antoniancu/vw-t2-ms3-custom-wiring/Wires.xls

 | Item | Type | Rel. Connector | Rel Color | AVG |  | Front Connector | Rear Connector | Other Destination | Cable Color | Comment | Length | Amps | Source | FromTo
17 | Aux+ | Power | AuxPowerBar | Yellow | 16 | 1 | FuseBlock B+ |  |  |  |  | 9 |  |  | Center-Front
18 | Bat+ | Power | BatPowerBar | Red | 16 | 2 | FuseBlock A+ |  |  |  |  | 9 |  |  | Center-Front
3 | Day Run Bulbs | Power |  |  |  |  |  |  |  |  |  |  | 0.6 | Aux+ | Manual Length
29 | ColdAirHSpeed | Power | C12M P3 | Yellow/Green | 16 | 3 | Conn2Fan2 P2 |  |  |  | 3.5 x 2 | 9 | 7 | Aux+ | Center-Front
2 | Off Road Lights | Power | C9L P2 | Yellow/Black | 18 | 1 | Conn1OffRoadLight P1 |  |  |  |  | 9 |  |  | Center-Front
4 | Low Beam Bulb Right | Power | C9L P4 | Green/Black | 18 | 2 | Conn3BeamR |  |  |  |  | 9 | 1.4 | Aux+ | Center-Front
5 | Low Beam Bulb Left | Power | C9L P5 | Green/Black/White | 18 | 3 | Conn3BeamL |  |  |  |  | 9 | 1.4 | Aux+ | Center-Front
7 | High Beam Bulb Right | Power | C9L P7 | Blue/Black | 18 | 4 | Conn3BeamR |  |  |  |  | 9 | 2.1 | Aux+ | Center-Front
8 | High Beam Bulb Left | Power | C9L P8 | Blue/Black/White | 18 | 5 | Conn3BeamL |  |  |  |  | 9 | 2.1 | Aux+ | Center-Front
10 | Trunk | Cmd+ | C9/7 P1 | Green | 22 |  |  | ??? |  |  |  | 16 |  |  | Center-Rear
11 | CutOff | CmdGnd | C9/7 P2 | Yellow | 22 |  |  | ??? |  |  |  | 16 |  |  | Center-Rear
15 | DoorOpen1 | Power | C9/7 P7 | White | 18 | 6 | Conn2RDoorOpen P1 |  |  |  |  | 9 | 3 | Bat+ | Center-Front
13 | Alarm BrakeTemoin | In | C9/7 P4 | Orange | 22 |  |  |  | Brake Pump Pins 81 |  |  | 6 |  |  | Manual Length
16 | DoorOpen2 | Power | C9/7 P6 | White/Black | 18 | 7 | Conn2RDoorOpen P2 |  |  |  |  | 9 | 3 | Bat+ | Center-Front
21 | WaserPump | Power | C34 P3 | Blue | 18 | 8 | Conn2WasherPump P1 |  |  |  |  | 9 | 1 |  | Center-Front
27 | WiperMotor_53 | Power | C12M P1 | Blue | 18 | 9 | ConnWiper 53 |  |  |  |  | 9 |  |  | Center-Front
28 | WiperMotor_53b | Power | C12M P2 | Green | 18 | 10 | ConnWiper 53b |  |  |  |  | 9 |  |  | Center-Front
30 | ColdAirLSpeed | Power | C12M P4 | White/Green | 18 | 11 | Conn2Fan2 P1 |  |  |  | 1.15 x 2 | 9 | 2.3 | Aux+ | Center-Front
33 | TurnPower | Power | C12M P7 | Red/Yellow | 18 | 12 | Conn9HSW P9 |  |  |  |  | 9 |  |  | Center-Front
35 | TurnBulbRF | Power | C12M P9 | Green/Black | 18 | 13 | Conn3FPR P1 |  |  |  |  | 9 | 1.5 | Aux+Bat+ | Center-Front
36 | TurnBulbLR | Power | C12M P10 | Blue/Black | 18 | 14 | ??? |  |  |  |  | 9 | 1.5 | Aux+Bat+ | Center-Front
37 | TurnBulbLF | Power | C12M P11 | Blue/Black | 18 | 15 | Conn3FPL P1 |  |  |  |  | 9 | 1.5 | Aux+Bat+ | Center-Front
1 | Off Road Cmd | CmdGnd | C9L P1 | Yellow | 22 | 1 | Conn3OffRoadSW P2 |  |  |  |  | 9 |  |  | Center-Front
6 | Low Beam Light Cmd | CmdGnd | C9L P6 | Green | 22 | 2 | Conn6Lights P6 |  |  |  |  | 9 |  |  | Center-Front
9 | Light Switch Cmd | CmdGnd | C9L P9 | Bkue | 22 | 3 | Conn6Dir P6 |  |  |  |  | 9 |  |  | Center-Front
12 | DoorSwitch | InGnd | C9/7 P3 | Blue | 22 | 4 | Conn1DoorSw |  |  |  |  | 9 |  |  | Center-Front
14 | Siren | Power | C9/7 P5 | Pink | 22 | 5 | Conn1Siren |  |  |  |  | 9 |  |  | Center-Front
19 | AuxCmd | CmdGnd | C34 P1 | Green | 22 | 6 | Conn4Key PinX |  |  |  |  | 9 |  |  | Center-Front
20 | WasherCmd | Cmd+ | C34 P2 | Blue | 22 | 7 | Conn7Wiper SW1 |  |  |  |  | 9 |  |  | Center-Front
22 | WiperMotor_53a | Power | C6/5 P1 | Yellow/Red | 22 | 8 | ConnWiper 53a |  |  |  |  | 9 |  |  | Center-Front
23 | WiperWCmd | Cmd+ | C6/5 P2 | White | 22 | 9 | Conn7Wiper SW2 |  |  |  |  | 9 |  |  | Center-Front
24 | WiperLTCmd | Cmd+ | C6/5 P3 | Blue + Blue/Black | 22 | 10 | Conn6WiperT P5 |  |  |  |  | 9 |  |  | Center-Front
25 | WiperMotor_53e | Cmd+ / Gnd | C6/5 P4 | Yellow | 22 | 11 | ConnWiper 53e |  |  |  |  | 9 |  |  | Center-Front
34 | TurnBulbRR | Power | C12M P8 | Green/Black | 18 |  |  | ??? |  |  |  | 16 | 1.5 | Aux+Bat+ | Center-Rear
26 | WiperHCmd | Cmd+ | C6/5 P5 | Green/Black | 22 | 12 | Conn7Wiper 53b |  |  |  |  | 9 |  |  | Center-Front
31 | ColdAirLCmd | CmdGnd | C12M P5 | White | 22 | 13 | Conn3ColdAirSW P1 |  |  |  |  | 9 |  |  | Center-Front
32 | ColdAirHCmd | CmdGnd | C12M P6 | Yellow | 22 | 14 | Conn3ColdAirSW P2 |  |  |  |  | 9 |  |  | Center-Front
38 | TurnIndicator | Power | C12M P12 | Black/Red | 22 | 15 | Conn9HSW P1 |  |  |  |  | 9 |  |  | Center-Front
39 | RightCmd | CmdGnd | C33 P3 | Green | 22 | 16 | Conn6Dir P3 |  |  |  |  | 9 |  |  | Center-Front
40 | HazardCmd | CmdGnd | C33 P2 | Yellow | 22 | 17 | Conn9HSW P8 |  |  |  |  | 9 |  |  | Center-Front
41 | LeftCmd | CmdGnd | C33 P1 | Blue | 22 | 18 | Conn6Dir P1 |  |  |  |  | 9 |  |  | Center-Front
42 | EngineBat+ | Power | BatPowerBar | Red | 16 |  |  | ??? |  |  |  | 16 |  |  | Center-Rear
43 | LeftSeatLCmd | Cmd+ | C42 P1 |  | 22 | 19 | Conn4SHL P4 |  |  |  |  | 9 |  |  | Center-Front
44 | LeftSeatHCmd | Cmd+ | C42 P2 |  | 22 | 20 | Conn4SHL P3 |  |  |  |  | 9 |  |  | Center-Front
45 | RightSeatLCmd | Cmd+ | C42 P3 |  | 22 | 21 | Conn4SHR P4 |  |  |  |  | 9 |  |  | Center-Front
46 | RightSeatHCmd | Cmd+ | C42 P4 |  | 22 | 22 | Conn4SGR P3 |  |  |  |  | 9 |  |  | Center-Front
47 | OilPresure | In+ |  |  | 22 | 1 | Conn4OilP P4 | Oil Presure Traductor |  |  |  | 25 |  |  | Front-Rear
48 | RPM | In+ |  |  | 22 | 2 | Conn9Dash P3 | Megasquirt |  |  |  | 25 |  |  | Front-Rear
49 | FuelLevel | In+ |  |  | 22 | 3 | Conn9Dash P4 | FuelTank |  |  |  | 25 |  |  | Front-Rear
50 | LowOilPresure | InGnd |  |  | 22 | 4 | Conn9Dash P5 | Megasquirt |  |  |  | 25 |  |  | Front-Rear
51 | AltCharge | InGnd |  |  | 22 | 5 | Conn9Dash P7 | Megasquirt |  |  |  | 25 |  |  | Front-Rear
52 | CheckEngine | InGnd |  |  | 22 | 6 | Conn9Dash P8 | Megasquirt |  |  |  | 25 |  |  | Front-Rear
53 | Brake | Sign+ |  |  | 22 |  | Conn4Brk P4 |  | Brake Pump Pins 81a |  |  | 6 |  |  | Manual Length
54 | HornPower | Power |  |  | 18 |  | FuseBlock B4 |  | Horn |  |  | 6 |  |  | Manual Length
55 | PowerBrakeSw | Power |  |  | 18 |  | FuseBlock B2 |  | Brake Pump Pins 82a |  |  | 9 | 3 | Aux+ | Manual Length
56 | CruiseControlGreen | Sign |  |  | 22 | 7 | Conn6Cruise 5 | CruiseControlUnit |  | Green |  | 25 |  |  | Front-Rear
57 | CruiseControlBrown | Sign |  |  | 22 | 8 | Conn6Cruise 4 | CruiseControlUnit |  | Brown |  | 25 |  |  | Front-Rear
58 | CruiseControlYellow | Sign |  |  | 22 | 9 | Conn6Cruise 3 | CruiseControlUnit |  | Yellow |  | 25 |  |  | Front-Rear
59 | RunCmd | CmdGnd |  |  | 22 | 10 | Conn4Key Pin15 | ??? |  |  |  | 25 |  |  | Front-Rear
60 | StartEngine | CmdGnd |  |  | 22 | 11 | Conn4Key Pin50 | ??? |  |  |  | 25 |  |  | Front-Rear
61 | PowerOutlet Left |  |  |  |  |  |  |  |  |  |  |  | 1.3 |  | Manual Length
62 | PowerOutlet Right |  |  |  |  |  |  |  |  |  |  |  | 5 | AuxBat | Manual Length
63 | AuxBat+(Heating) | Power |  |  | 10 |  | Conn3HAirSw P3 |  | ??? |  |  |  |  |  | Manual Length
64 | FansCmd | Cmd+ | ??? |  | 22 | 23 | Conn3HAirSw P1 |  |  |  |  | 9 |  |  | Center-Front
65 | FlameCmd | Cmd+ | ??? |  | 22 | 24 | Conn3BA6Temp P2 |  |  |  |  | 9 |  |  | Center-Front
66 | Back Lights |  |  |  | 18 |  |  |  |  |  |  | 9 | 5 | AuxBat | Manual Length
67 | Left Seat Heater |  |  |  |  |  |  |  |  |  |  |  | 2.45 | Aux+ | Manual Length
68 | Right Seat Heater |  |  |  |  |  |  |  |  |  |  |  | 2.45 | Aux+ | Manual Length
69 | Rear Heating Fan |  | ??? |  |  |  |  | ??? |  |  |  |  | 3.7 | Aux+ | Center-Rear
70 | Temp K wires |  |  |  | 20 | 12 | ??? | ??? |  |  |  |  |  |  | Front-Rear
71 | Temp K wires |  |  |  | 20 | 13 | ??? | ??? |  |  |  |  |  |  | Front-Rear
72 | Alarm Light |  | ??? |  | 22 | 25 | ??? |  |  |  |  |  |  |  | Center-Front
73 | Alarm Light |  | ??? |  | 22 | 26 | ??? |  |  |  |  |  |  |  | Center-Front
74 | Alarm Antena |  | ??? |  | 22 | 27 | ??? |  |  |  |  |  |  |  | Center-Front
75 | TractionControl |  |  |  | 22 | 14 | ??? | ??? |  |  |  |  |  |  | Front-Rear
76 | SportMode |  |  |  | 22 | 15 | ??? | ??? |  |  |  |  |  |  | Front-Rear
 |  |  |  |  |  |  |  |  |  |  |  |  | 27.8
