antoniancu/vw-t2-ms3-custom-wiring/CablingModule1-Cabling_Schema_By_Module_1.pdf

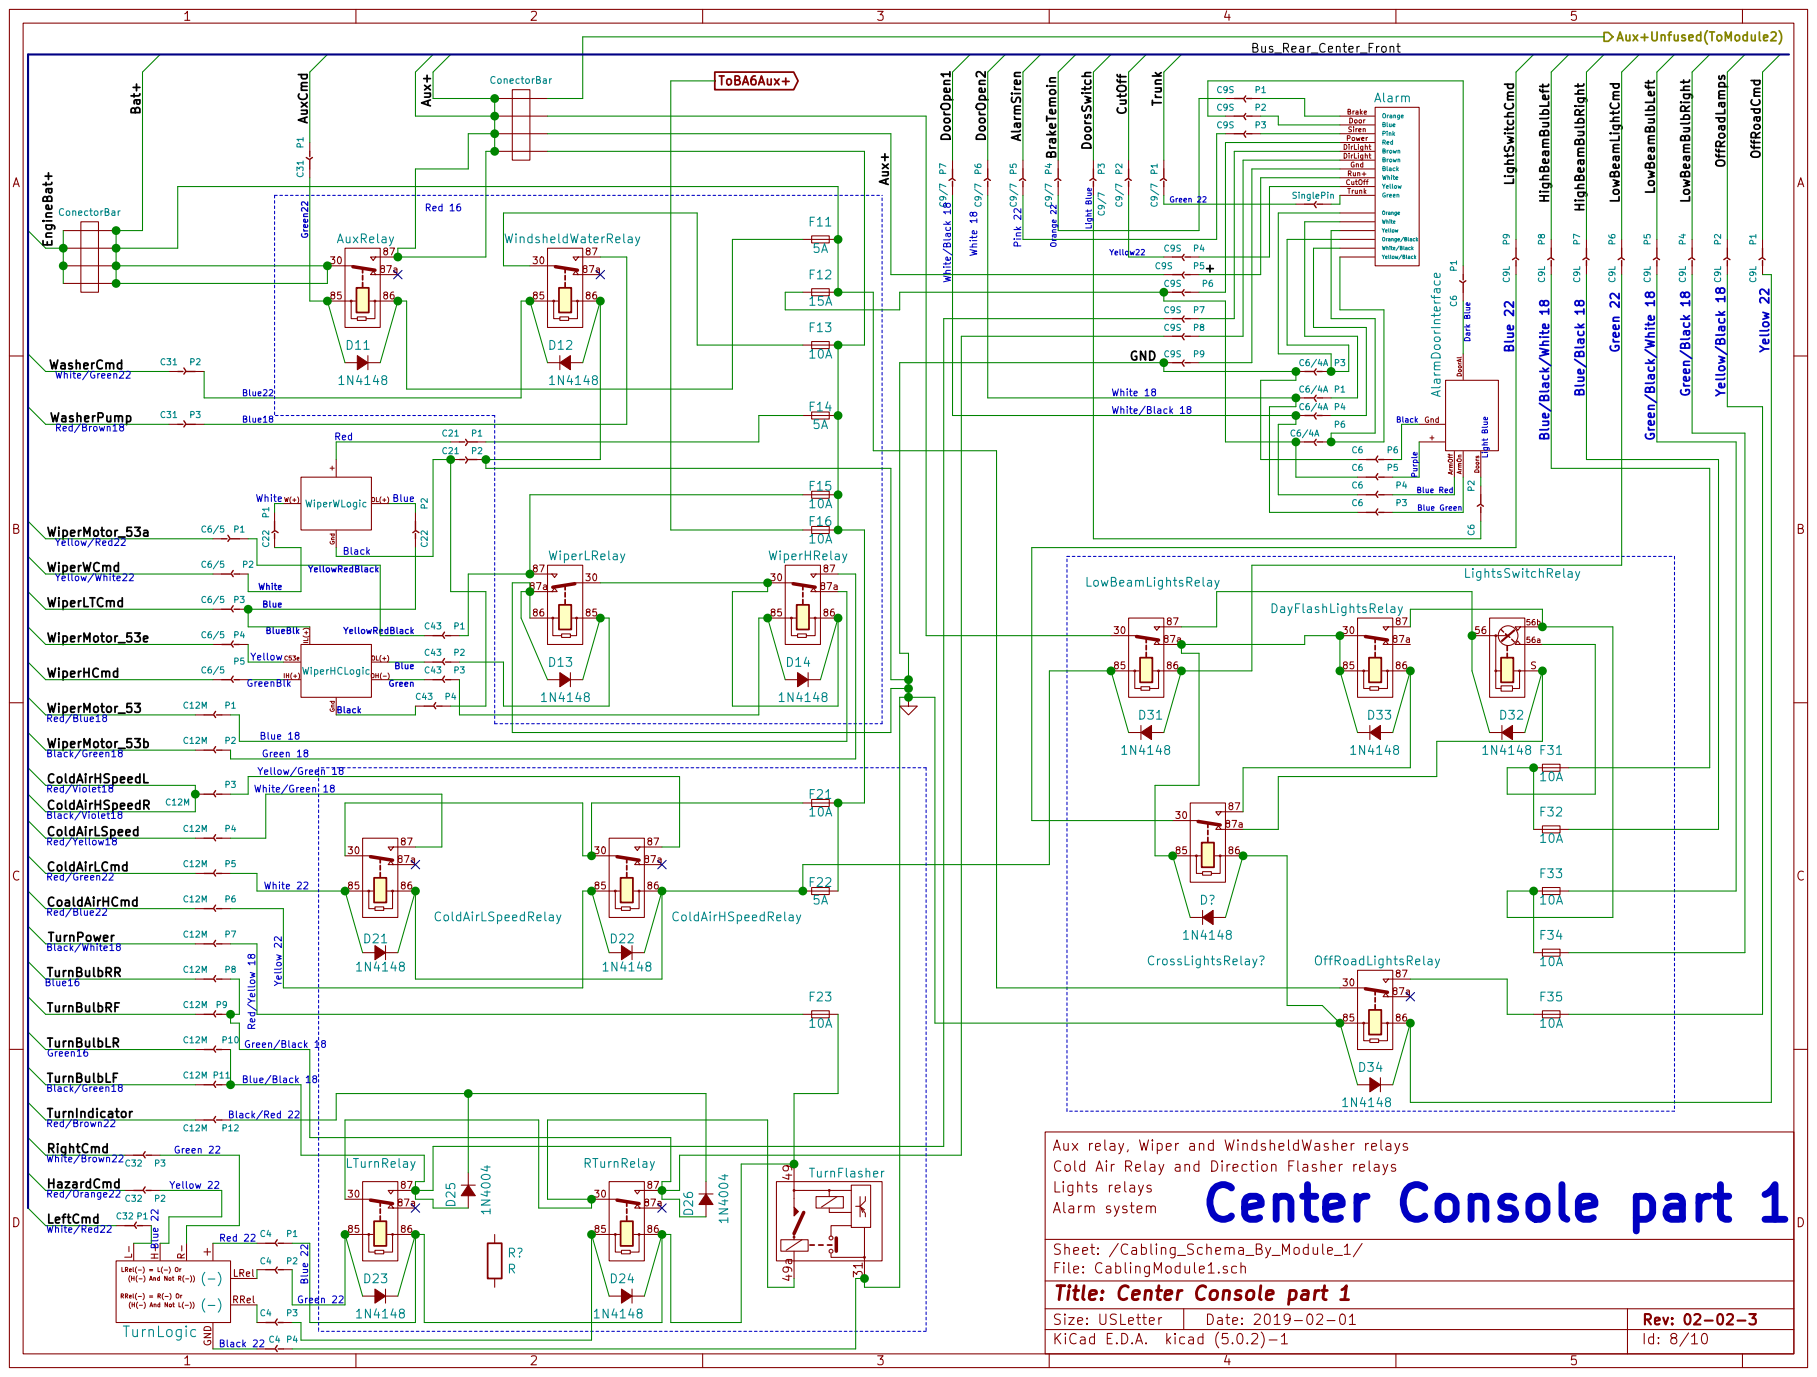
[picture p1: page 1]

+ Gnd W(+) OL(+) WiperWLogic ConectorBar Red 16 C9S P9 Aux+

WiperHCmd
Red/Violet18 Black/Violet18 Red/Yellow18 Red/Green22 Red/Blue22 Black/Green18 White/Red22 White/Brown22

Aux relay, Wiper and WindsheldWasher relays
Cold Air Relay and Direction Flasher relays
Center Console part 1

Lights relays
Alarm system
Sheet: /Cabling_Schema_By_Module_1/
File: CablingModule1.sch
Id: 8/10 Title: Center Console part 1
