antoniancu/vw-t2-ms3-custom-wiring/CablingModule2-Cabling_Schema_by_Module_2.pdf

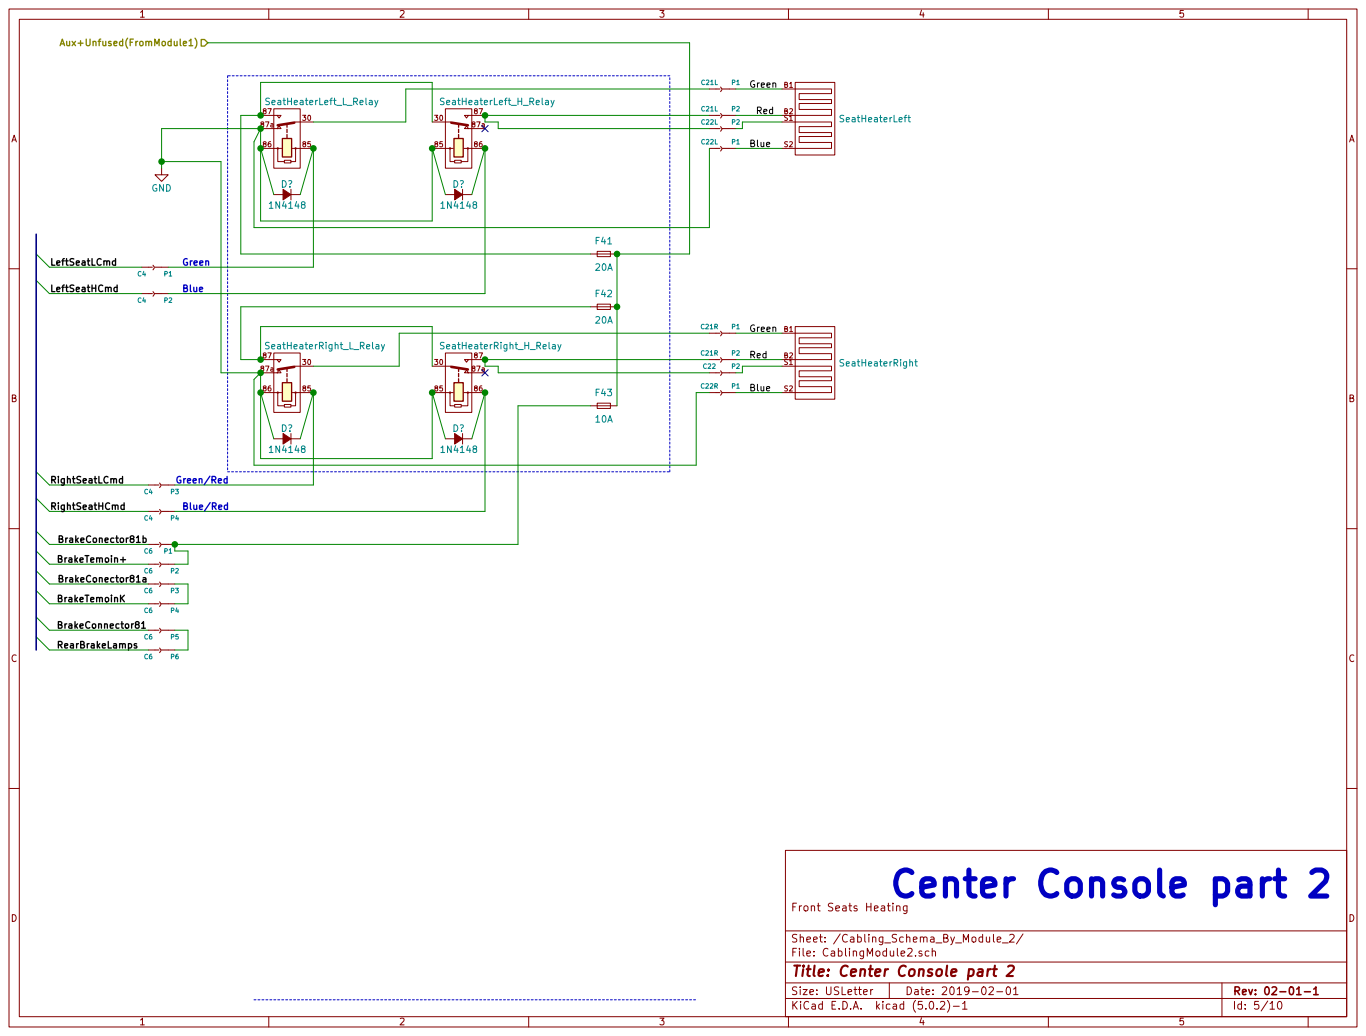
[picture p2: page 1]

Front Seats Heating
Sheet: /Cabling_Schema_By_Module_2/
File: CablingModule2.sch
Id: 5/10 Title: Center Console part 2
