antoniancu/vw-t2-ms3-custom-wiring/CablingModule3_Tabloid-Cabling Schema Front (Tabloid).pdf

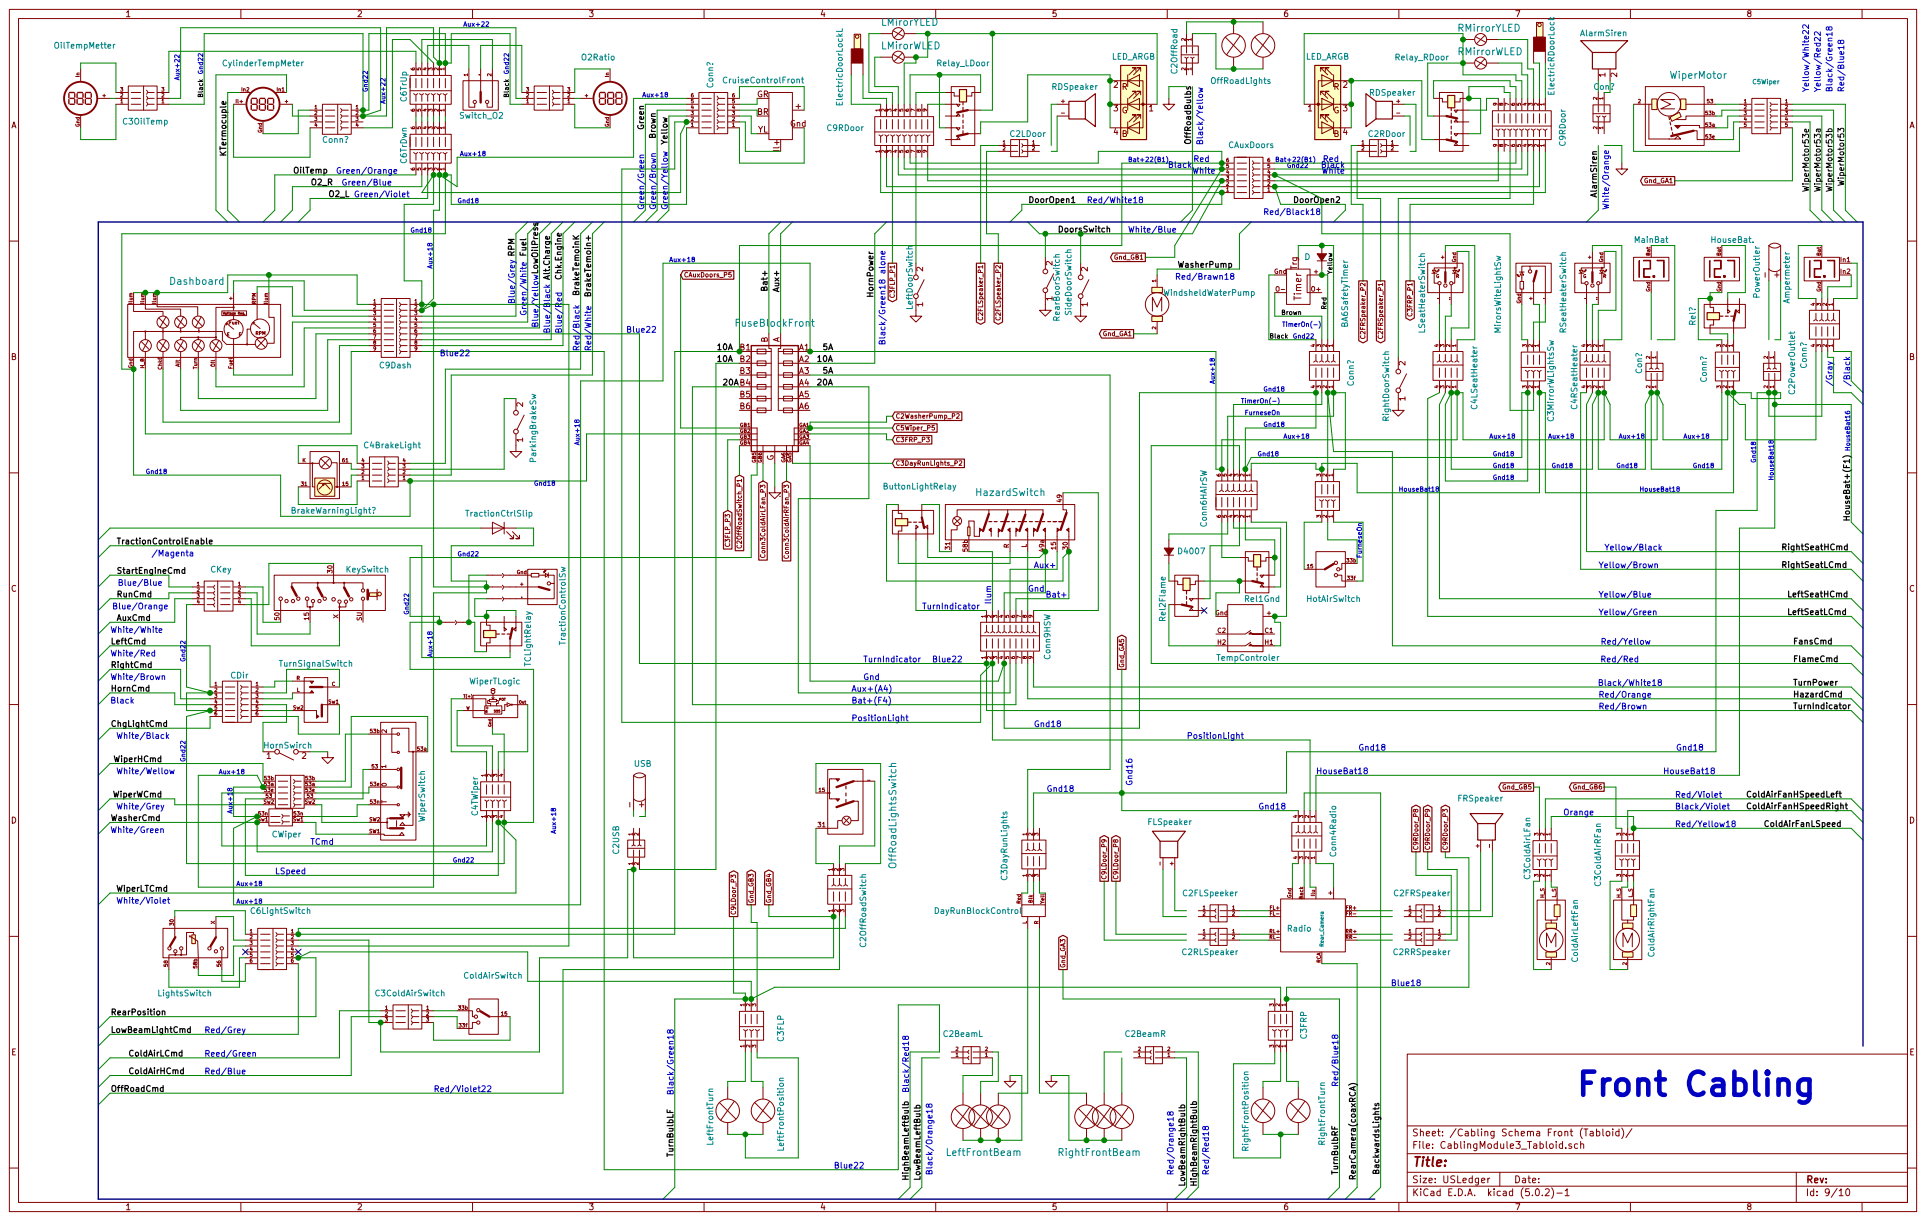
[picture p3: page 1]

1 2 SideDoorSwitch 1 2 LeftDoorSwitch 1 2 RearBoorSwitch ElectricRDoorLock ElectricDoorLockL

2 C2OffRoad 2 Relay_RDoor Relay_LDoor Black/Orange18 Red/Orange18 Red/Red18 Black/Red181 1

4 4 Conn? Gnd18 FurneseOn TimerOn(-) Gnd22 FurneseOn RearCamera(coaxRCA) BackwardsLights BrakeTemoin+

-+ FLSpeaker C9LDoor_P9 C9LDoor_P8 Gnd_GA3 C3FRP_P3 Bat+ TurnIndicator TurnIndicator PositionLight

TractionControlEnable
White/White White/Green White/Grey White/Violet White/Wellow
Sw1 Sw2 TurnSignalSwitch LeftCmd RightCmd

+Back FL+ FL- FR+ FR- Gnd Ilu Rear_Camera RCA RL+ RL- RR+ RR- Radio

Sheet: /Cabling Schema Front (Tabloid)/
File: CablingModule3_Tabloid.sch
Id: 9/10 Title:
