antoniancu/vw-t2-ms3-custom-wiring/EngineAndRear-EngineAndRear.pdf

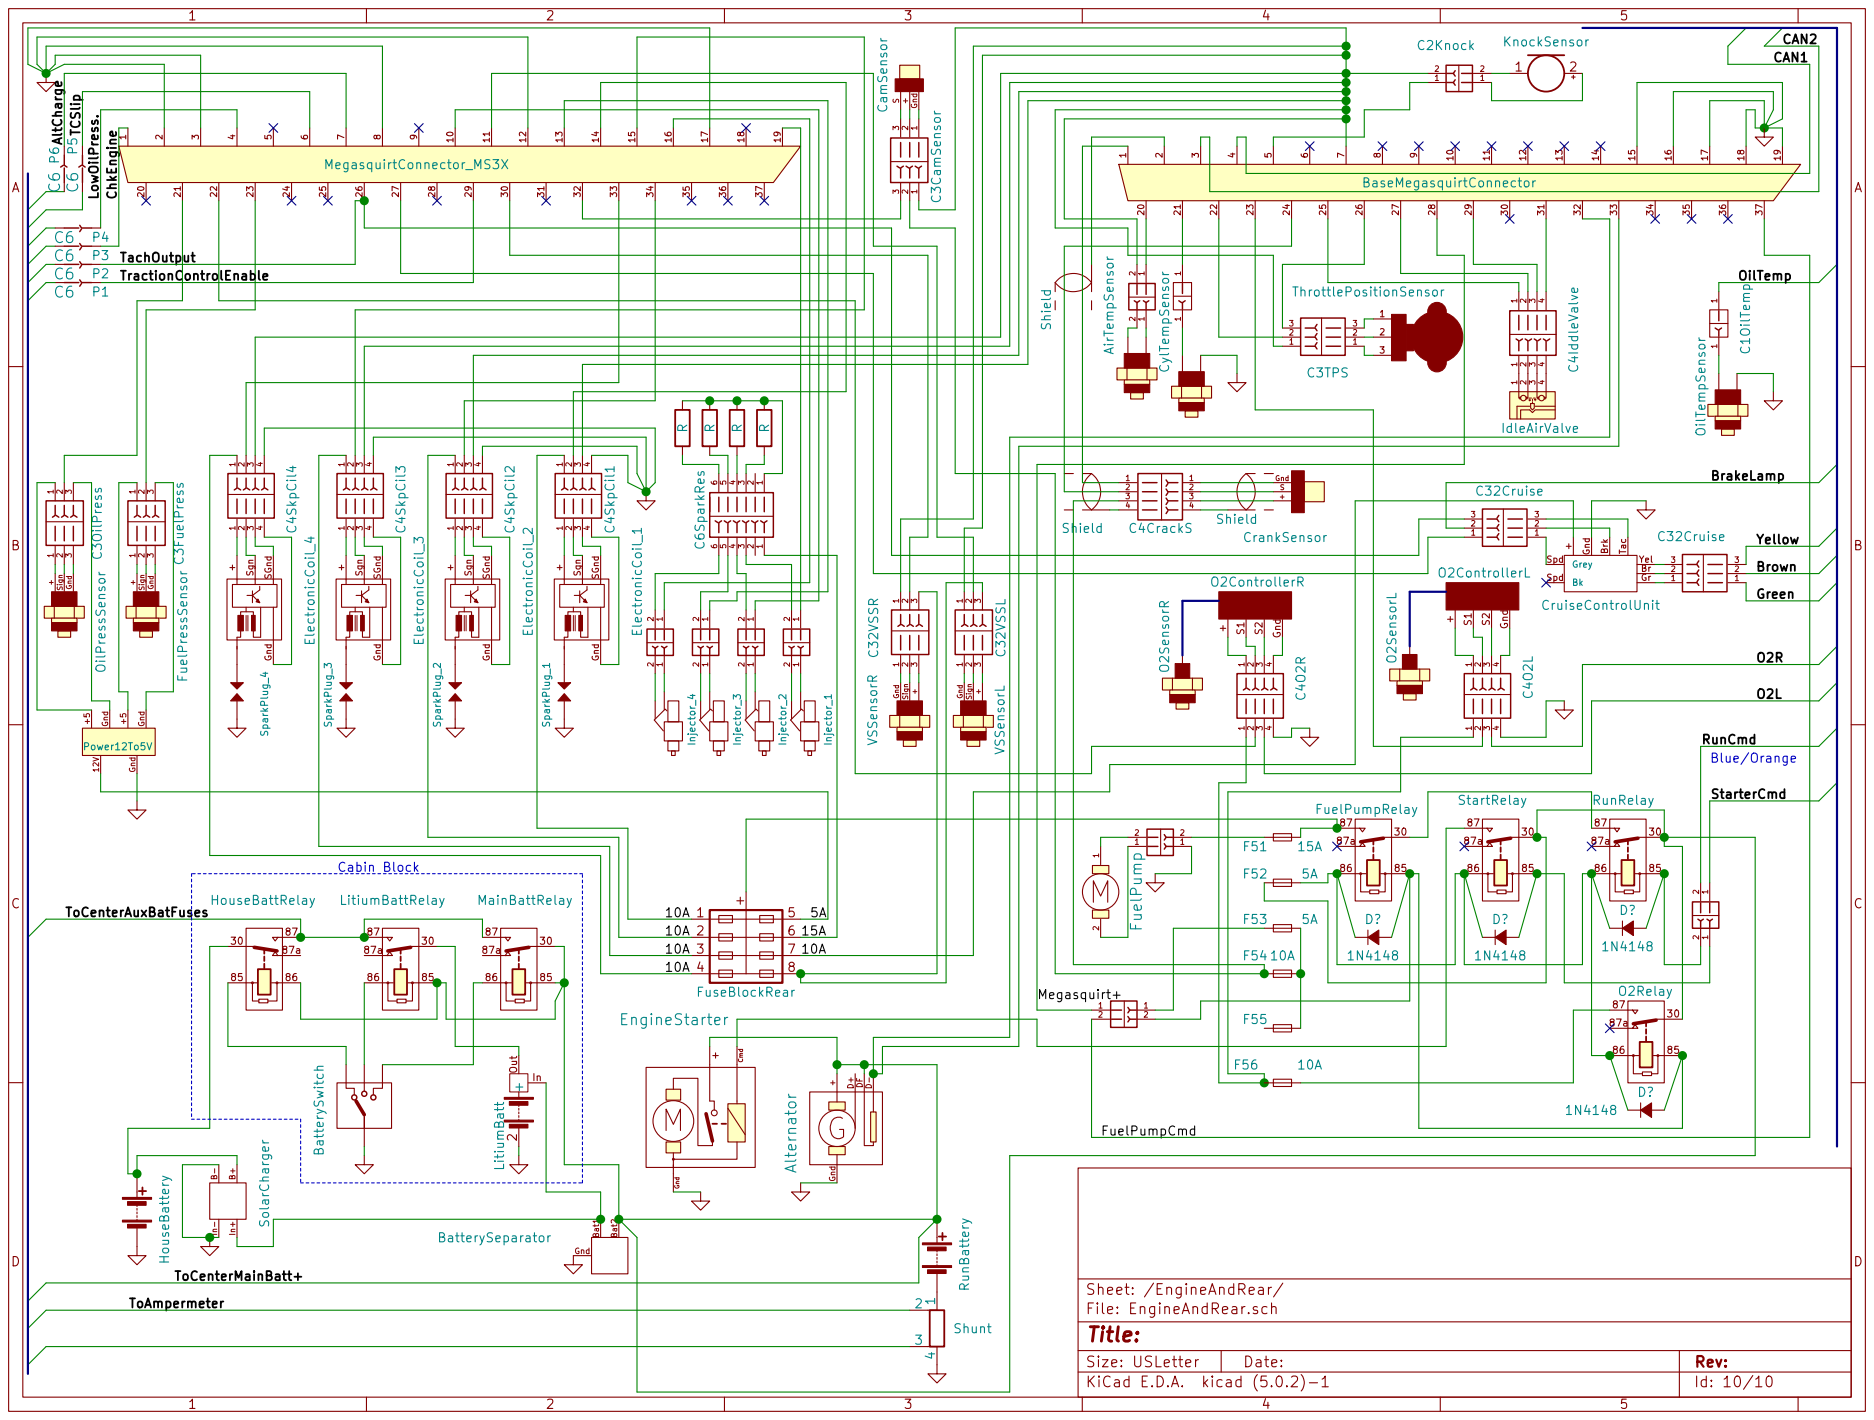
[picture p4: page 1]

+ Sign Gnd OilPressSensor+ Sign Gnd FuelPressSensor +5+5 12V Gnd Gnd Gnd Power12To5V TractionControlEnable TachOutput 1 1

+ Gnd SGnd Sgn ElectronicCoil_1 + Gnd SGnd Sgn ElectronicCoil_2 + Gnd SGnd Sgn ElectronicCoil_3 + Gnd SGnd Sgn ElectronicCoil_4 SparkPlug_4 SparkPlug_3 SparkPlug_2 SparkPlug_1 Injector_4 Injector_3 Injector_2 Injector_1 RunBattery

+ Br Gnd Brk Gr Bk Spd Grey Spd Tac Yel CruiseControlUnit 1 1

+D+ DFD- GndAlternator HouseBattery B- B+ In- In+SolarChargerBatterySwitch
