antoniancu/vw-t2-ms3-custom-wiring/LogicModule1-Logic_Schema_By_Module_1.pdf

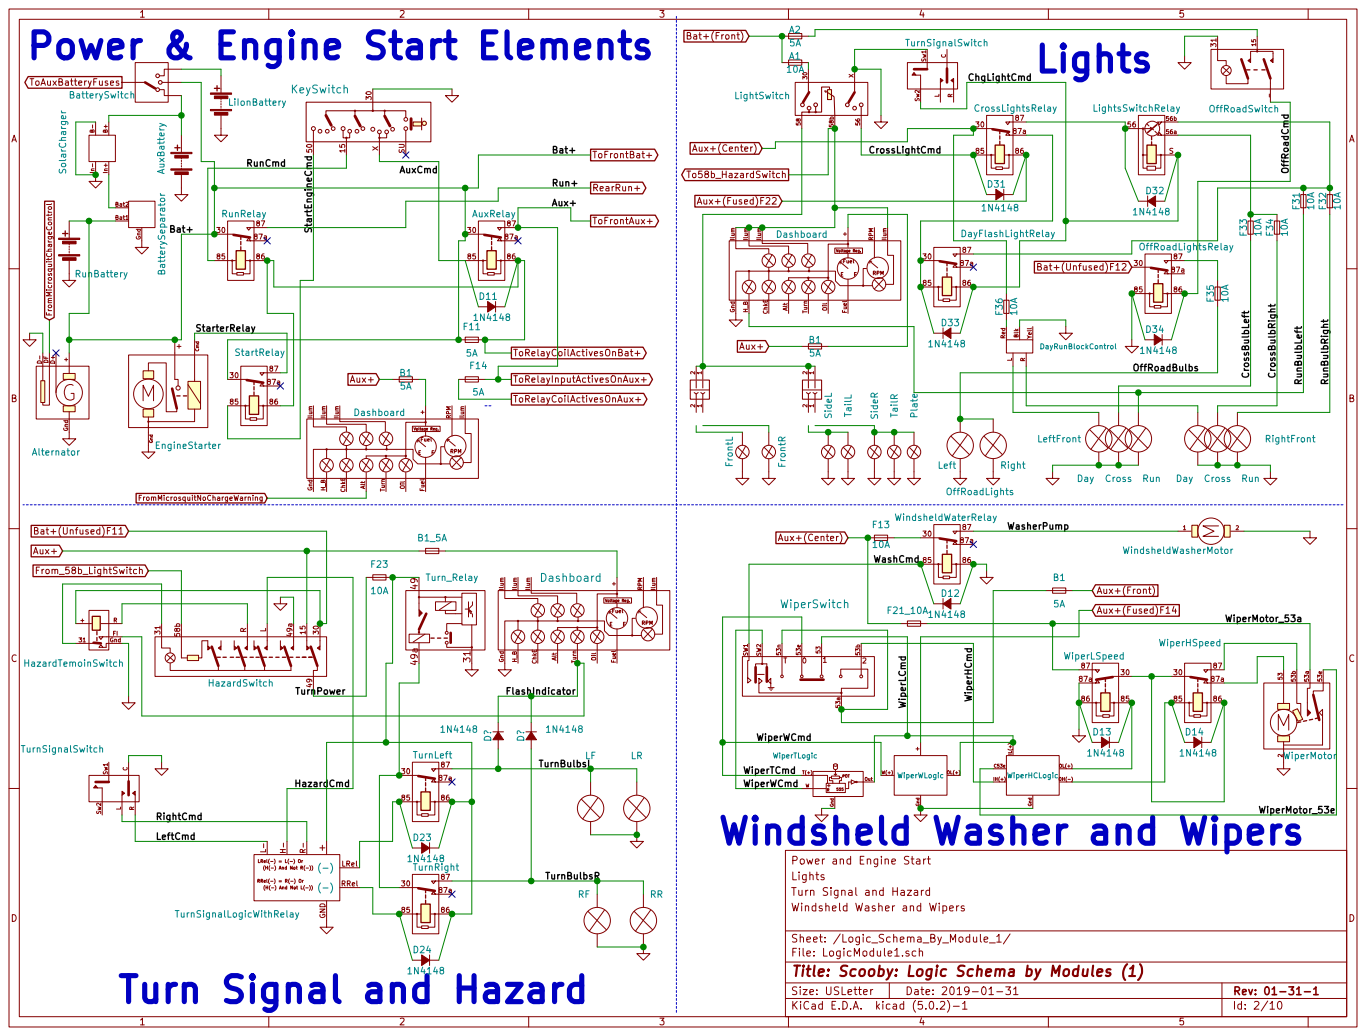
[picture p5: page 1]

Power & Engine Start Elements
1N4148 WiperWCmd

10A Windsheld Washer and Wipers

Power and Engine Start
Lights
Turn Signal and Hazard
Windsheld Washer and Wipers
Sheet: /Logic_Schema_By_Module_1/
File: LogicModule1.sch
Id: 2/10 Title: Scooby: Logic Schema by Modules (1)
