antoniancu/vw-t2-ms3-custom-wiring/LogicModule2-Logic_Schema_By_Module_2.pdf

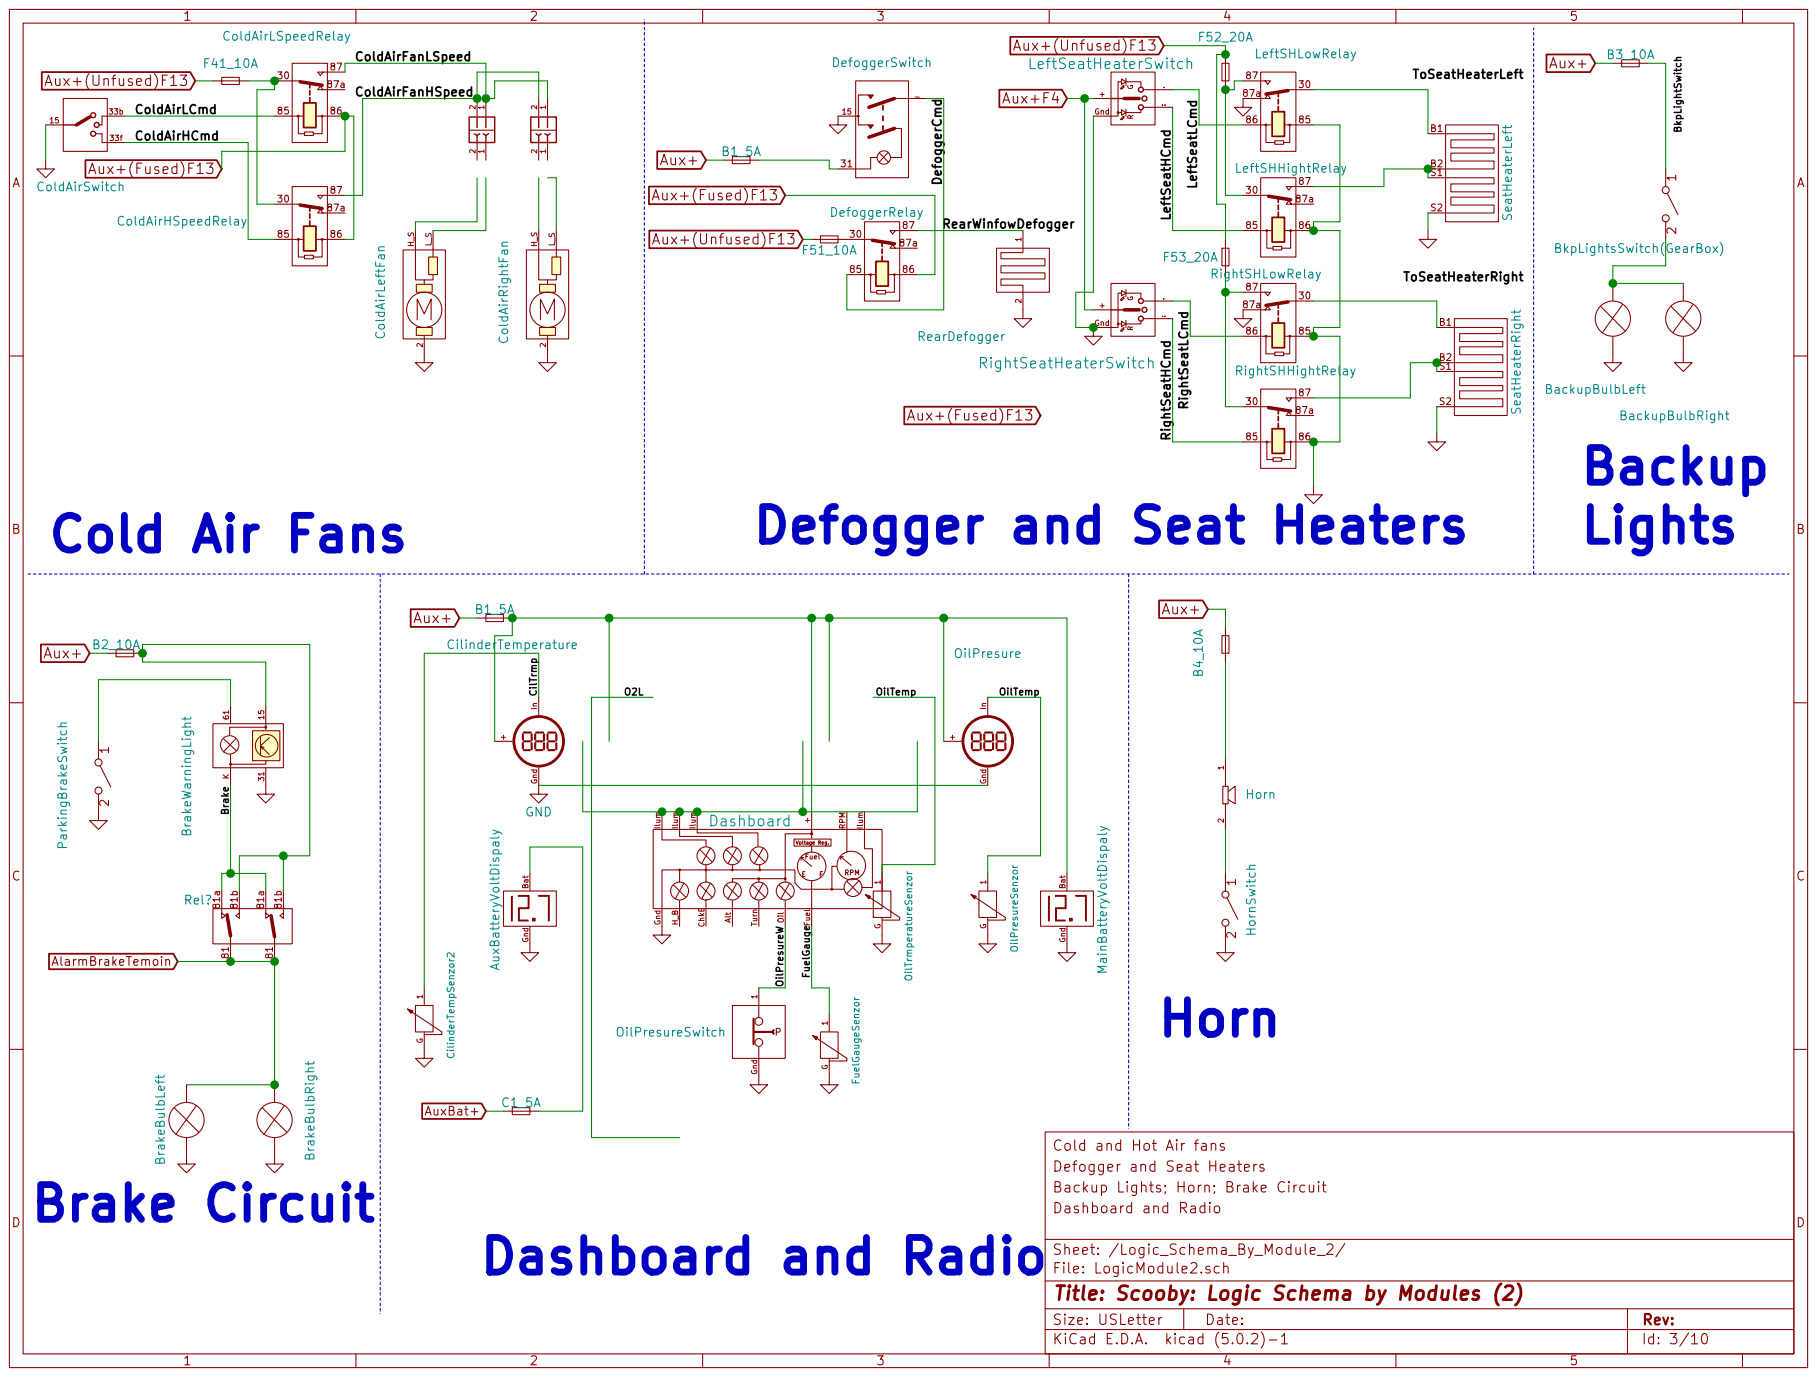
[picture p6: page 1]

F52_20A Defogger and Seat Heaters

Defogger and Seat Heaters Cold and Hot Air fans M

1 2 Horn 15 31 61 K BrakeWarningLight 1 2 ParkingBrakeSwitch 8181 Rel? 81a 81b 81a 81b BrakeBulbLeft BrakeBulbRight B2_10A Aux+ Brake Circuit

Sheet: /Logic_Schema_By_Module_2/ Dashboard and Radio Backup Lights; Horn; Brake Circuit

File: LogicModule2.sch
Id: 3/10 Title: Scooby: Logic Schema by Modules (2)
