antoniancu/vw-t2-ms3-custom-wiring/LogicModule4-Logic_Schema_By_Module_4.pdf

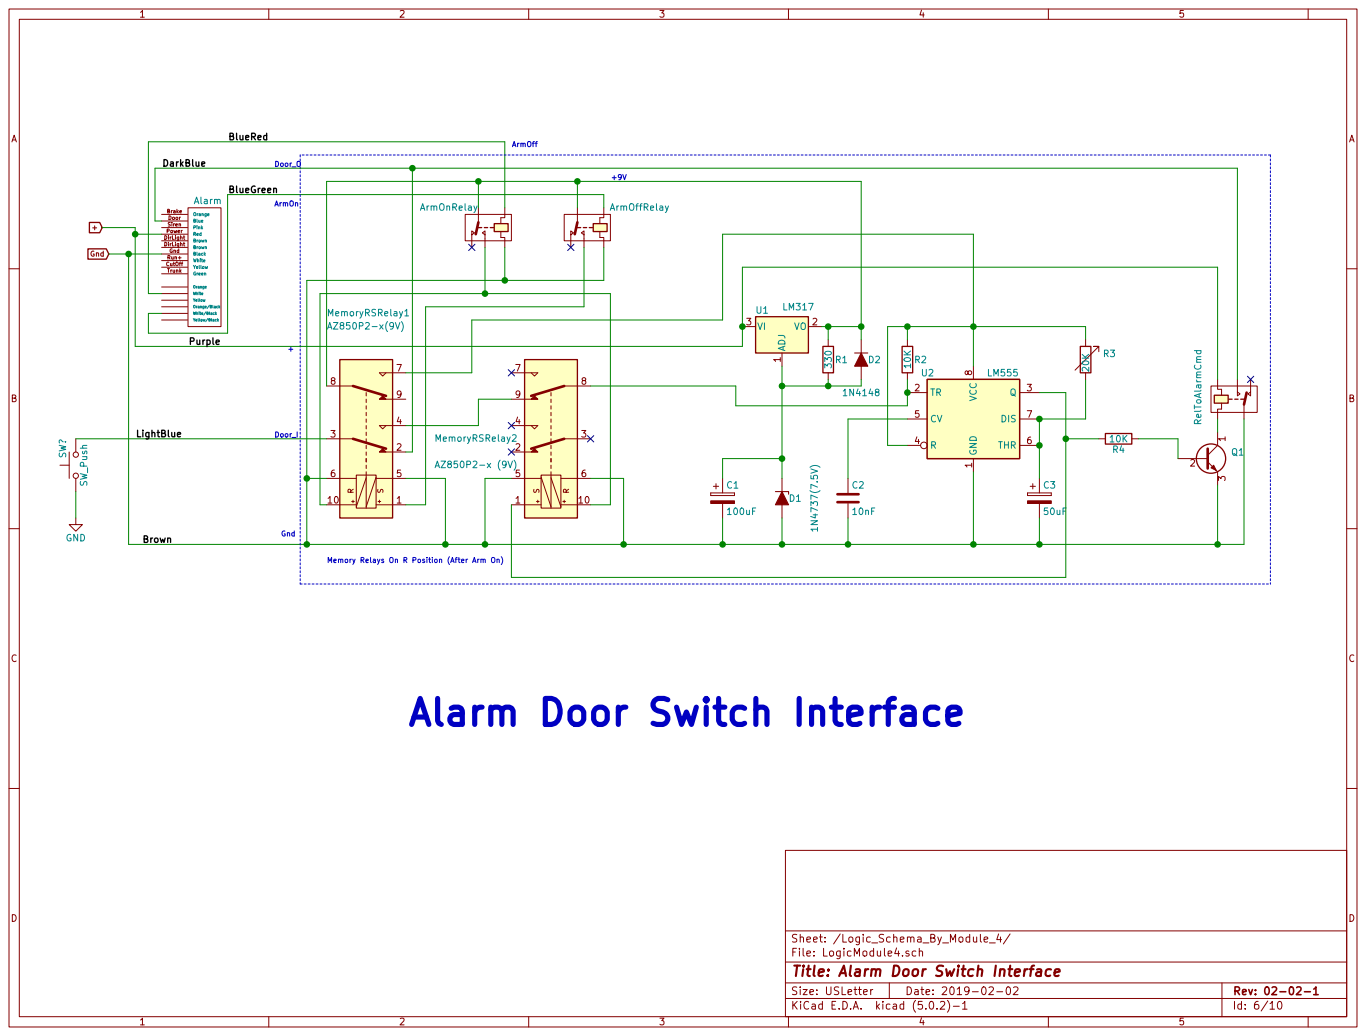
[picture p7: page 1]

9 MemoryRSRelay1

Sheet: /Logic_Schema_By_Module_4/
File: LogicModule4.sch
Id: 6/10 Title: Alarm Door Switch Interface
