antoniancu/vw-t2-ms3-custom-wiring/LogicModule5-Heating.pdf

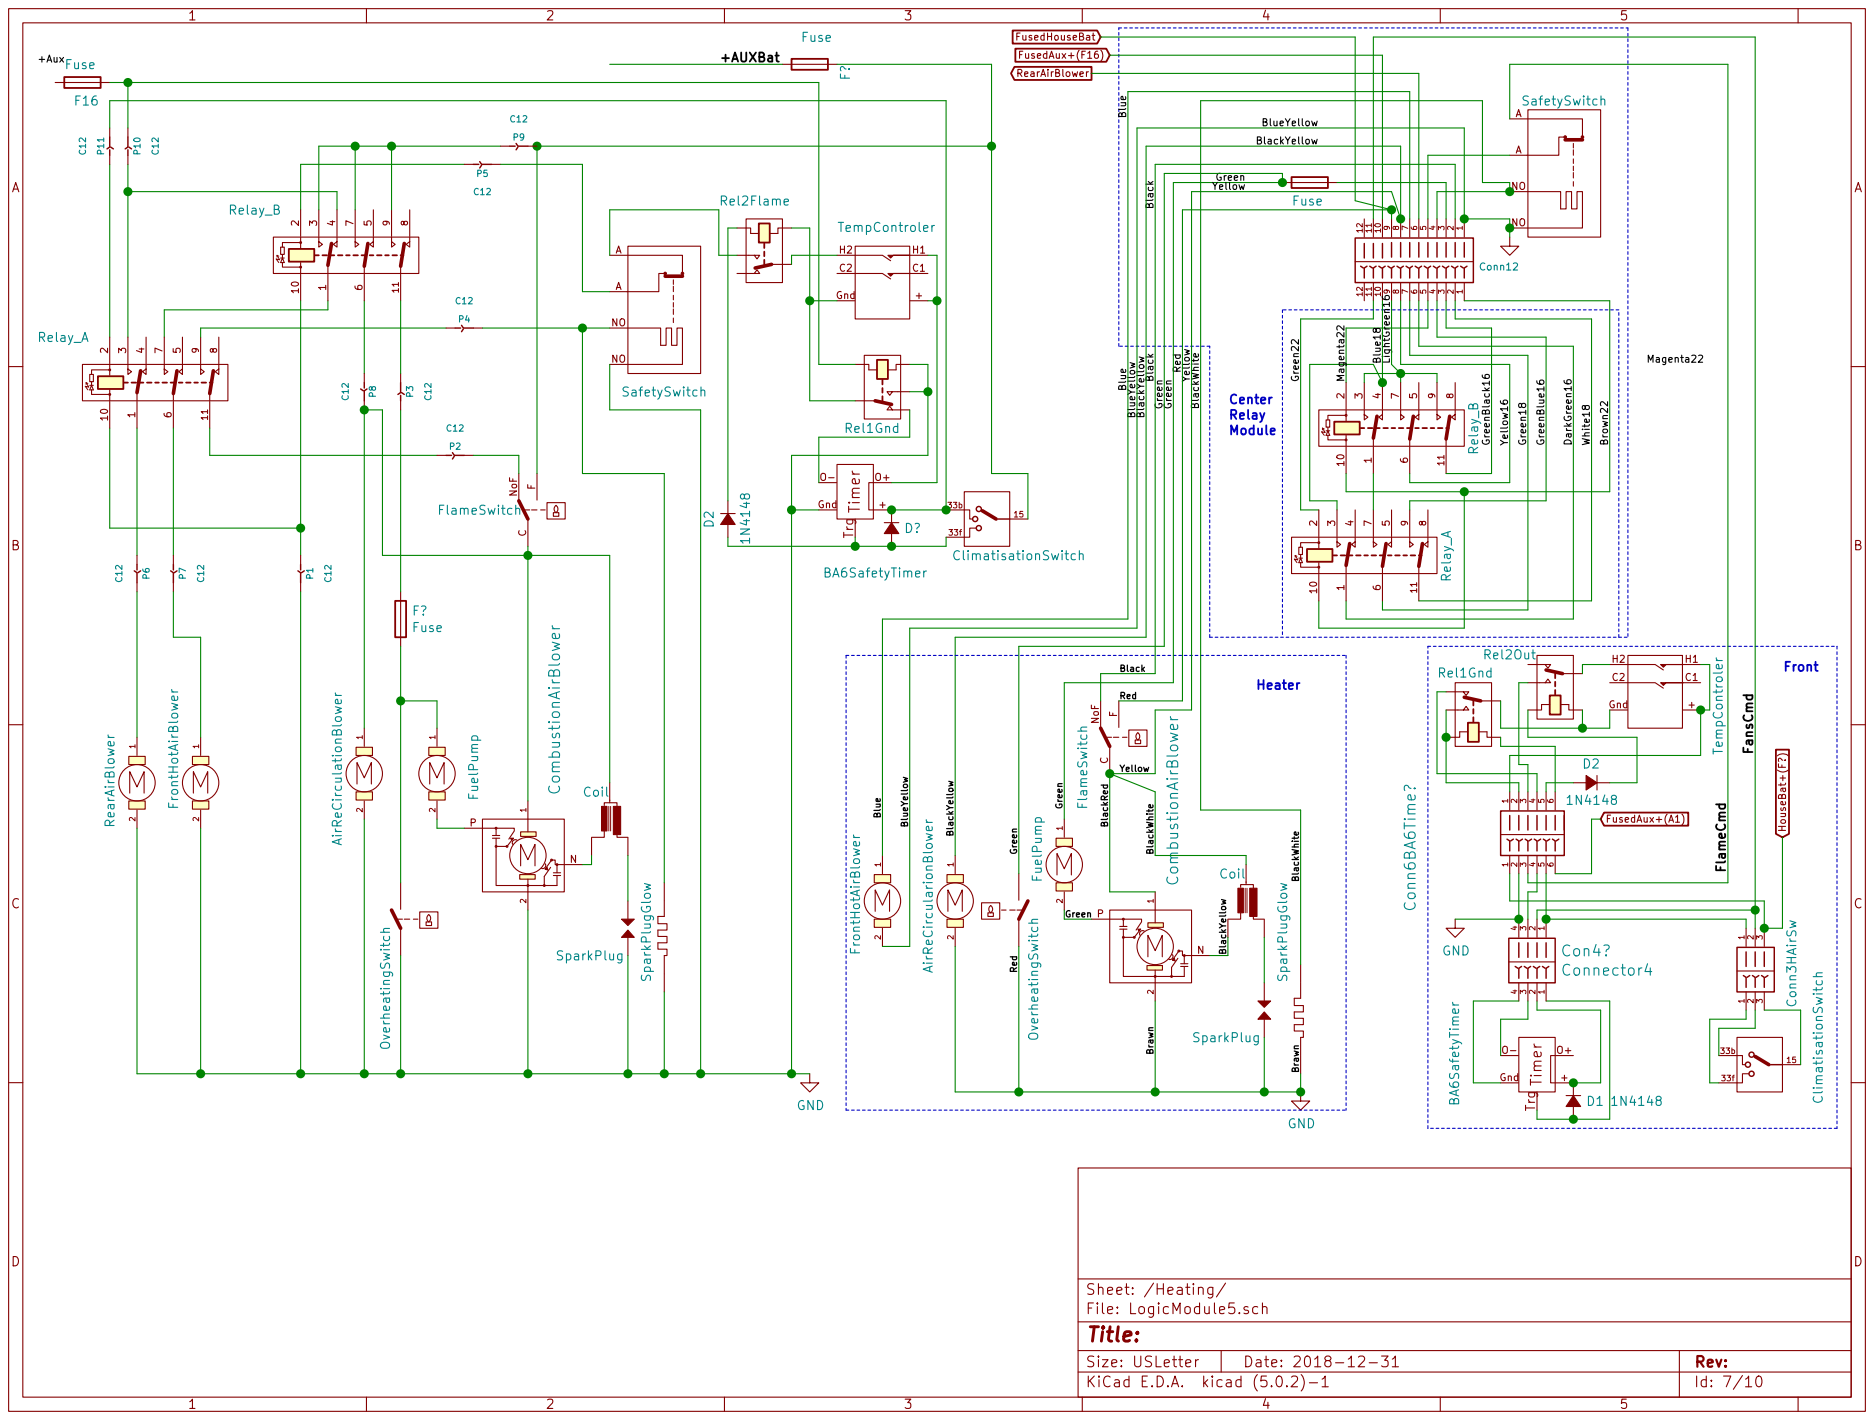
[picture p8: page 1]

1 2 FrontHotAirBlower FlameCmd FansCmd GreenBlack16 GreenBlue16 White18 Brown22 Magenta22 Yellow16 Green18 DarkGreen16 LightGreen16 Magenta22 Yellow BlackRed BlackWhite Red Black Green Green Brawn BlackYellow Green Red BlackYellow Brawn BlackWhite BlueYellow Blue Yellow Black Green BlueYellow Blue Green22 Rel1Gnd Rel2Flame Rel1Gnd

FNoF FlameSwitch Front Heater Center Relay Module M
