antoniancu/vw-t2-ms3-custom-wiring/Scooby.pdf

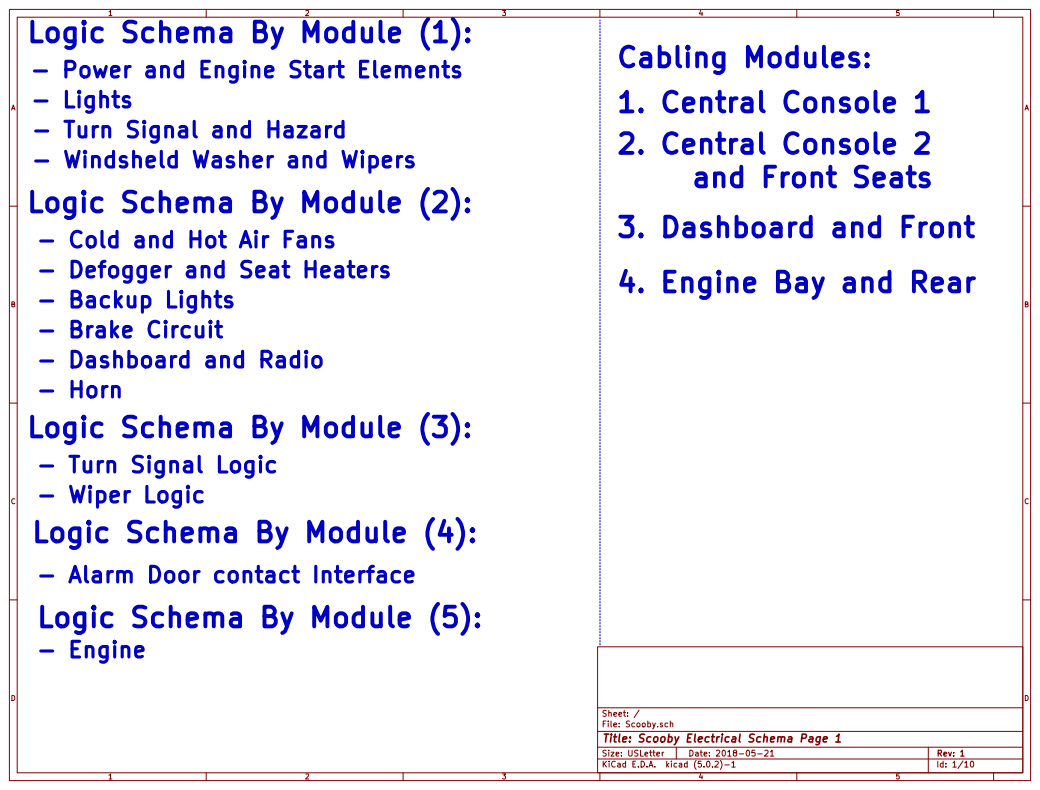
[picture p9: page 1]

File: Scooby.sch Sheet: / Logic_Schema_By_Module_1

Logic Schema By Module (1):
- Power and Engine Start Elements
- Lights
- Turn Signal and Hazard
- Windsheld Washer and Wipers
Logic Schema By Module (2):
- Cold and Hot Air Fans
- Defogger and Seat Heaters
- Backup Lights
- Brake Circuit
- Dashboard and Radio
- Horn
Logic Schema By Module (3):
- Turn Signal Logic
- Wiper Logic
Logic Schema By Module (4):
- Alarm Door contact Interface
Logic Schema By Module (5):
- Engine

Cabling Modules:
1. Central Console 1
2. Central Console 2
and Front Seats
3. Dashboard and Front
4. Engine Bay and Rear

Id: 1/10 Title: Scooby Electrical Schema Page 1

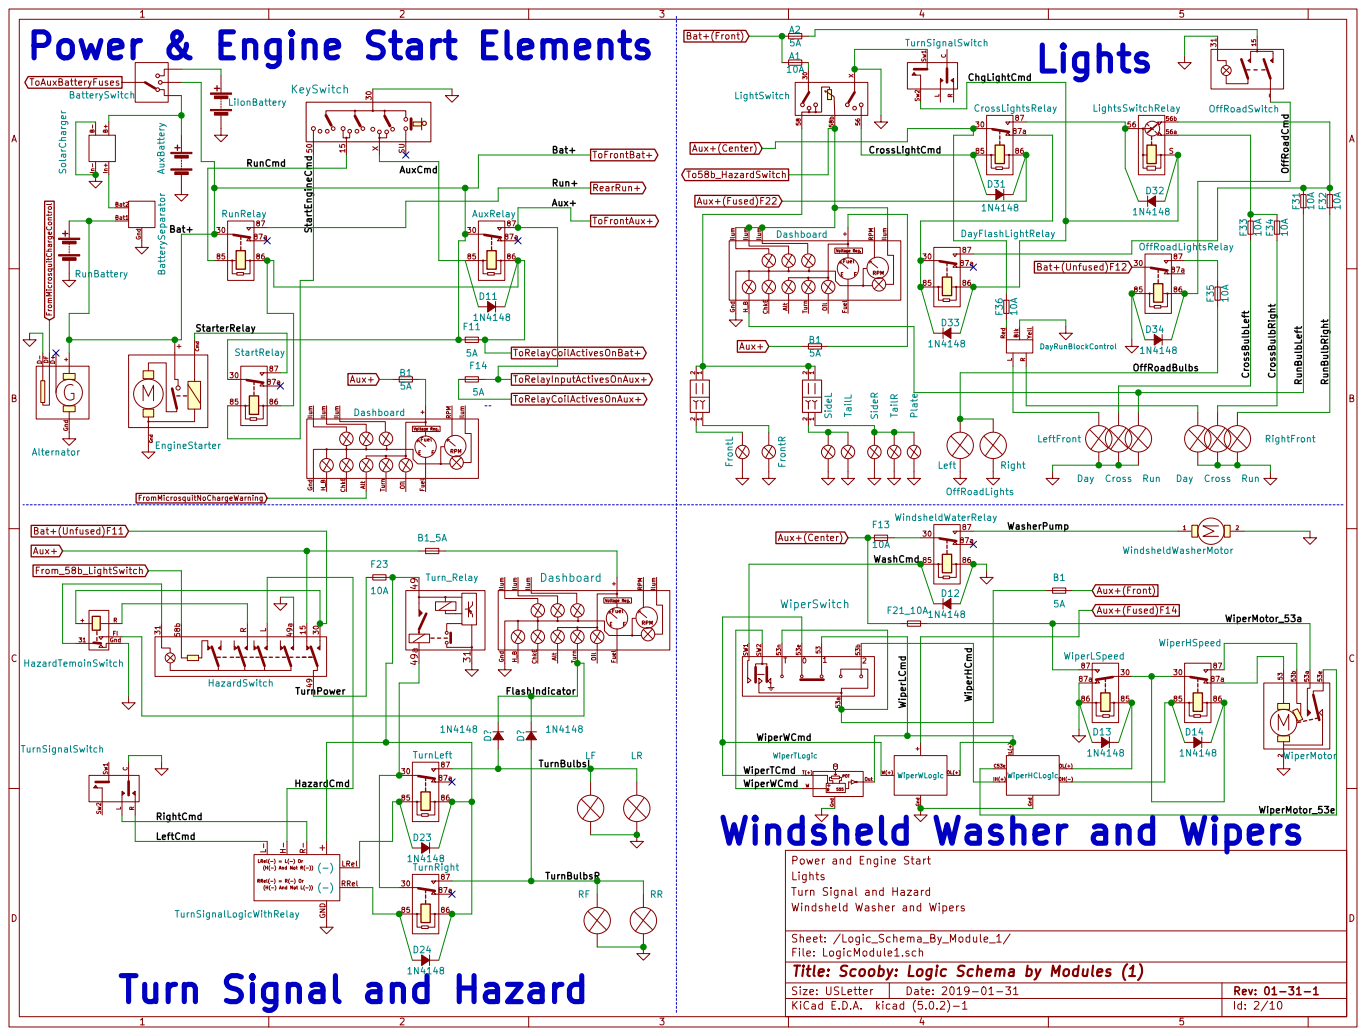
[picture p10: page 2]

Power & Engine Start Elements
1N4148 WiperWCmd

10A Windsheld Washer and Wipers

Power and Engine Start
Lights
Turn Signal and Hazard
Windsheld Washer and Wipers
Sheet: /Logic_Schema_By_Module_1/
File: LogicModule1.sch
Id: 2/10 Title: Scooby: Logic Schema by Modules (1)

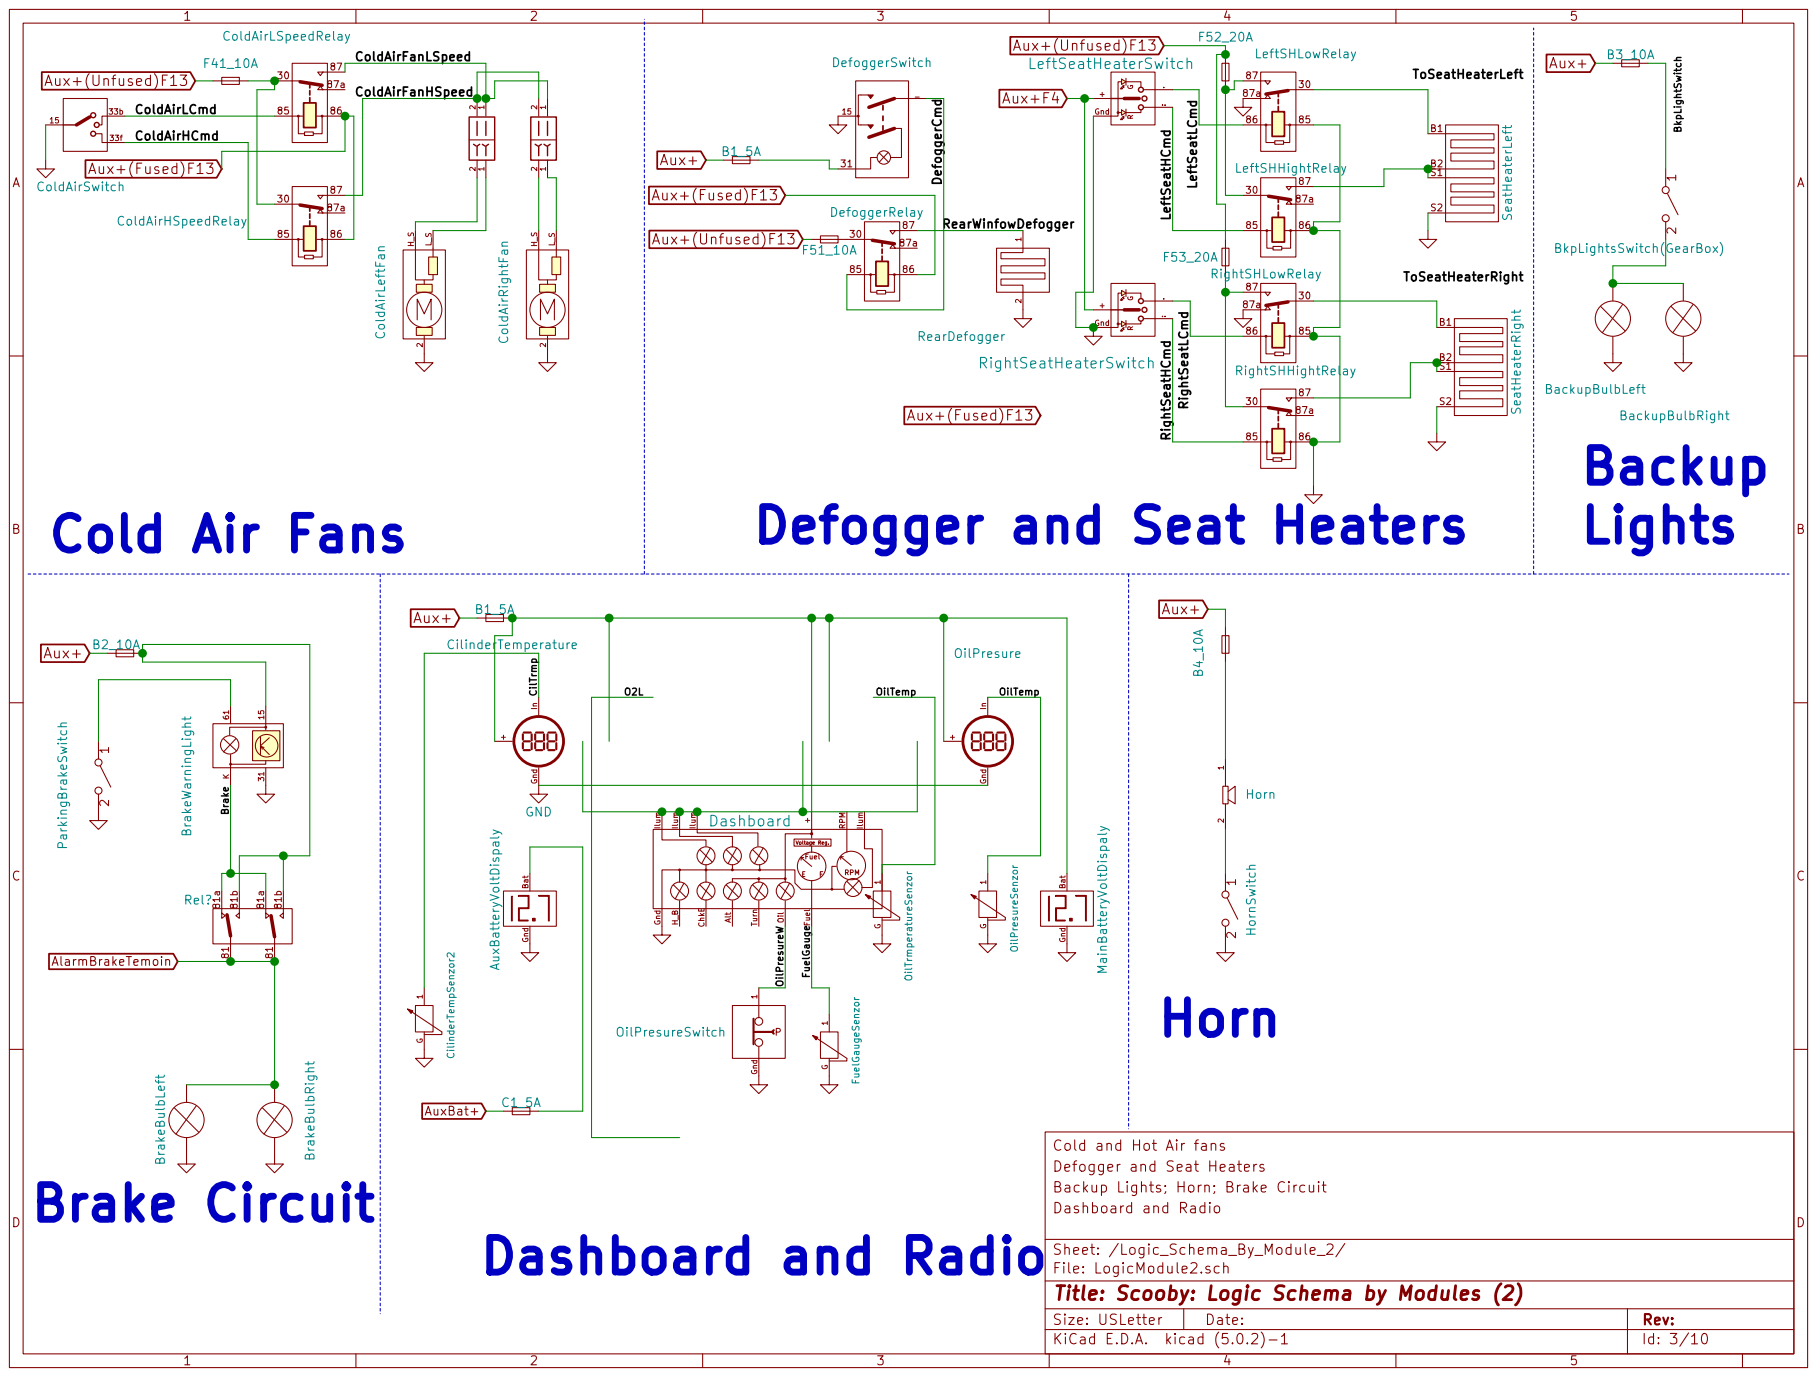
[picture p11: page 3]

F52_20A Defogger and Seat Heaters

Defogger and Seat Heaters Cold and Hot Air fans M

1 2 Horn 15 31 61 K BrakeWarningLight 1 2 ParkingBrakeSwitch 8181 Rel? 81a 81b 81a 81b BrakeBulbLeft BrakeBulbRight B2_10A Aux+ Brake Circuit

Sheet: /Logic_Schema_By_Module_2/ Dashboard and Radio Backup Lights; Horn; Brake Circuit

File: LogicModule2.sch
Id: 3/10 Title: Scooby: Logic Schema by Modules (2)

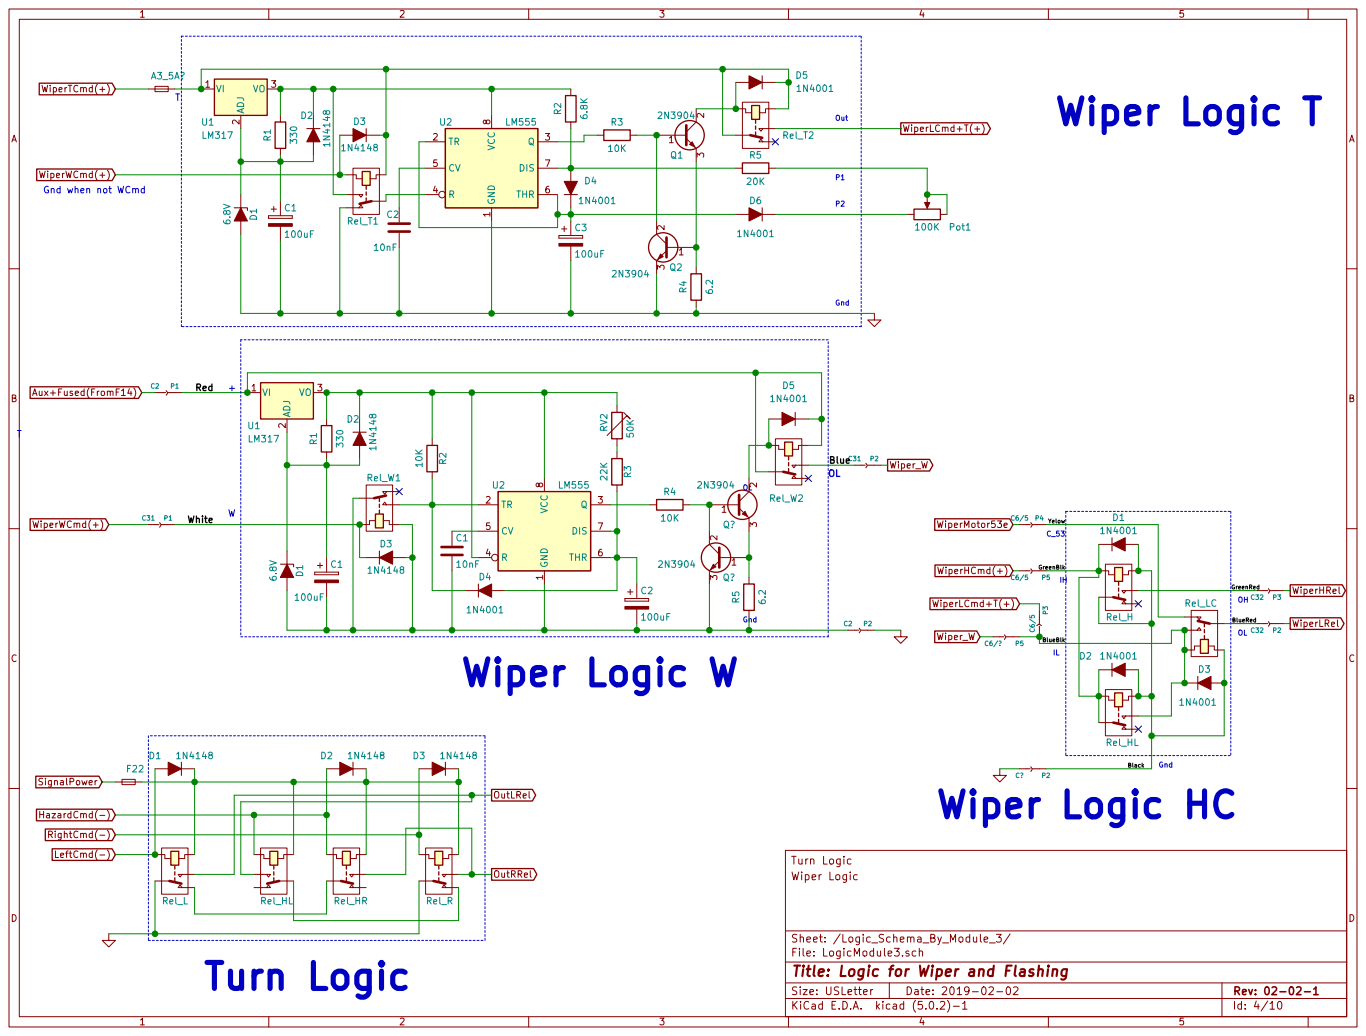
[picture p12: page 4]

Sheet: /Logic_Schema_By_Module_3/
File: LogicModule3.sch
Id: 4/10 Title: Logic for Wiper and Flashing


Front Seats Heating
Sheet: /Cabling_Schema_By_Module_2/
File: CablingModule2.sch
Id: 5/10 Title: Center Console part 2


9 MemoryRSRelay1

Sheet: /Logic_Schema_By_Module_4/
File: LogicModule4.sch
Id: 6/10 Title: Alarm Door Switch Interface

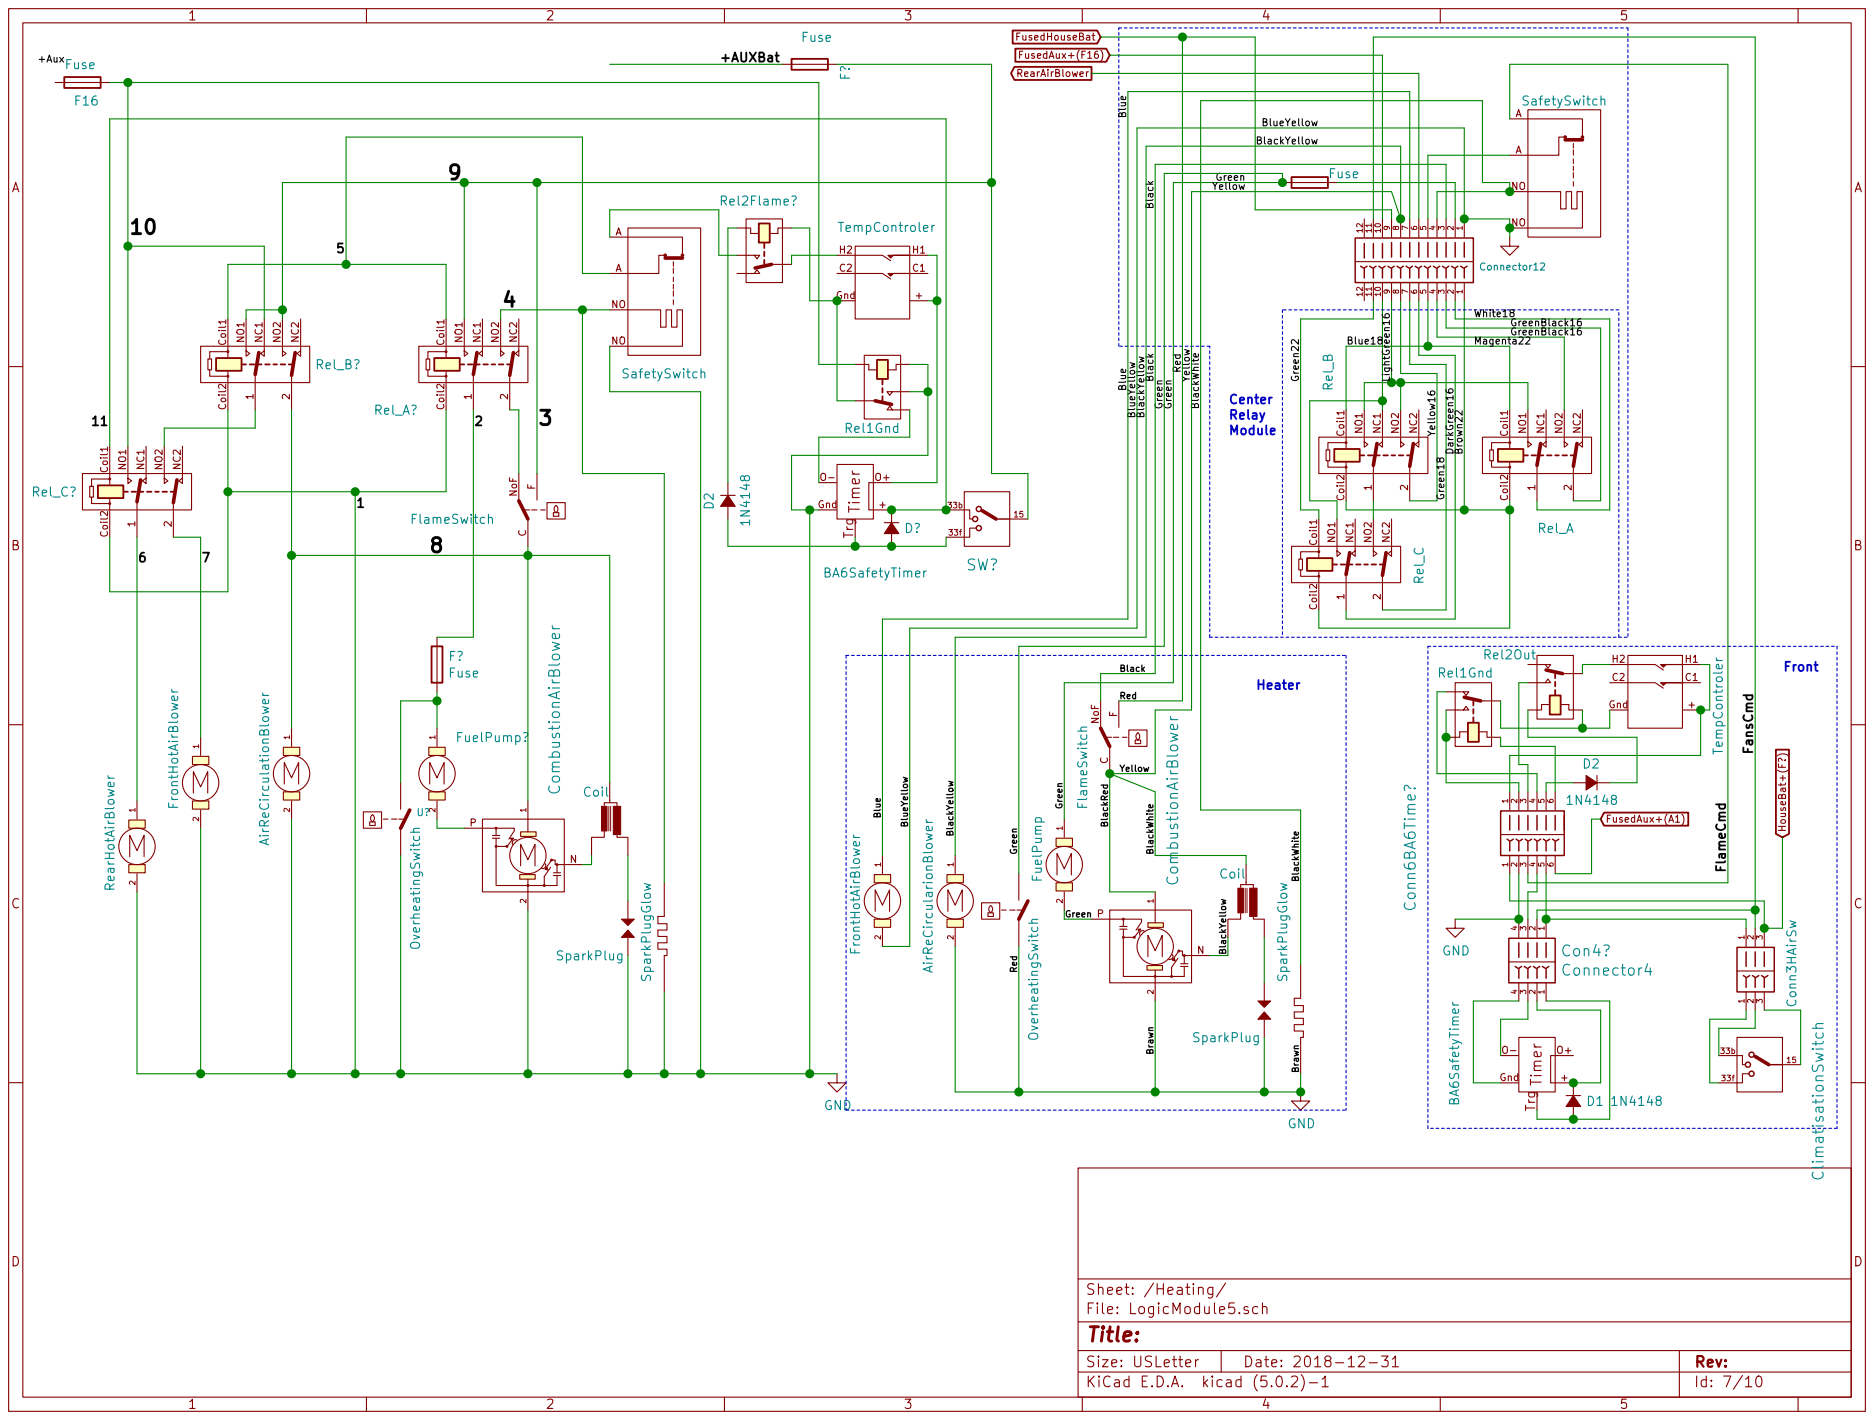
[picture p13: page 7]

1 2 FrontHotAirBlower FlameCmd FansCmd Brown22 White18GreenBlack16 GreenBlack16 Magenta22 DarkGreen16 Green18 Yellow16 LightGreen16 Blue18 Yellow BlackRed BlackWhite Red Black Green Green Brawn BlackYellow Green Red BlackYellow Brawn BlackWhite BlueYellow Blue Yellow Black Green BlueYellow Blue Green22 Rel1Gnd Rel2Flame? Rel1Gnd

FNoF FlameSwitch Front Heater Center Relay Module


+ Gnd W(+) OL(+) WiperWLogic ConectorBar Red 16 C9S P9 Aux+

WiperHCmd
Red/Violet18 Black/Violet18 Red/Yellow18 Red/Green22 Red/Blue22 Black/Green18 White/Red22 White/Brown22

Aux relay, Wiper and WindsheldWasher relays
Cold Air Relay and Direction Flasher relays
Center Console part 1

Lights relays
Alarm system
Sheet: /Cabling_Schema_By_Module_1/
File: CablingModule1.sch
Id: 8/10 Title: Center Console part 1

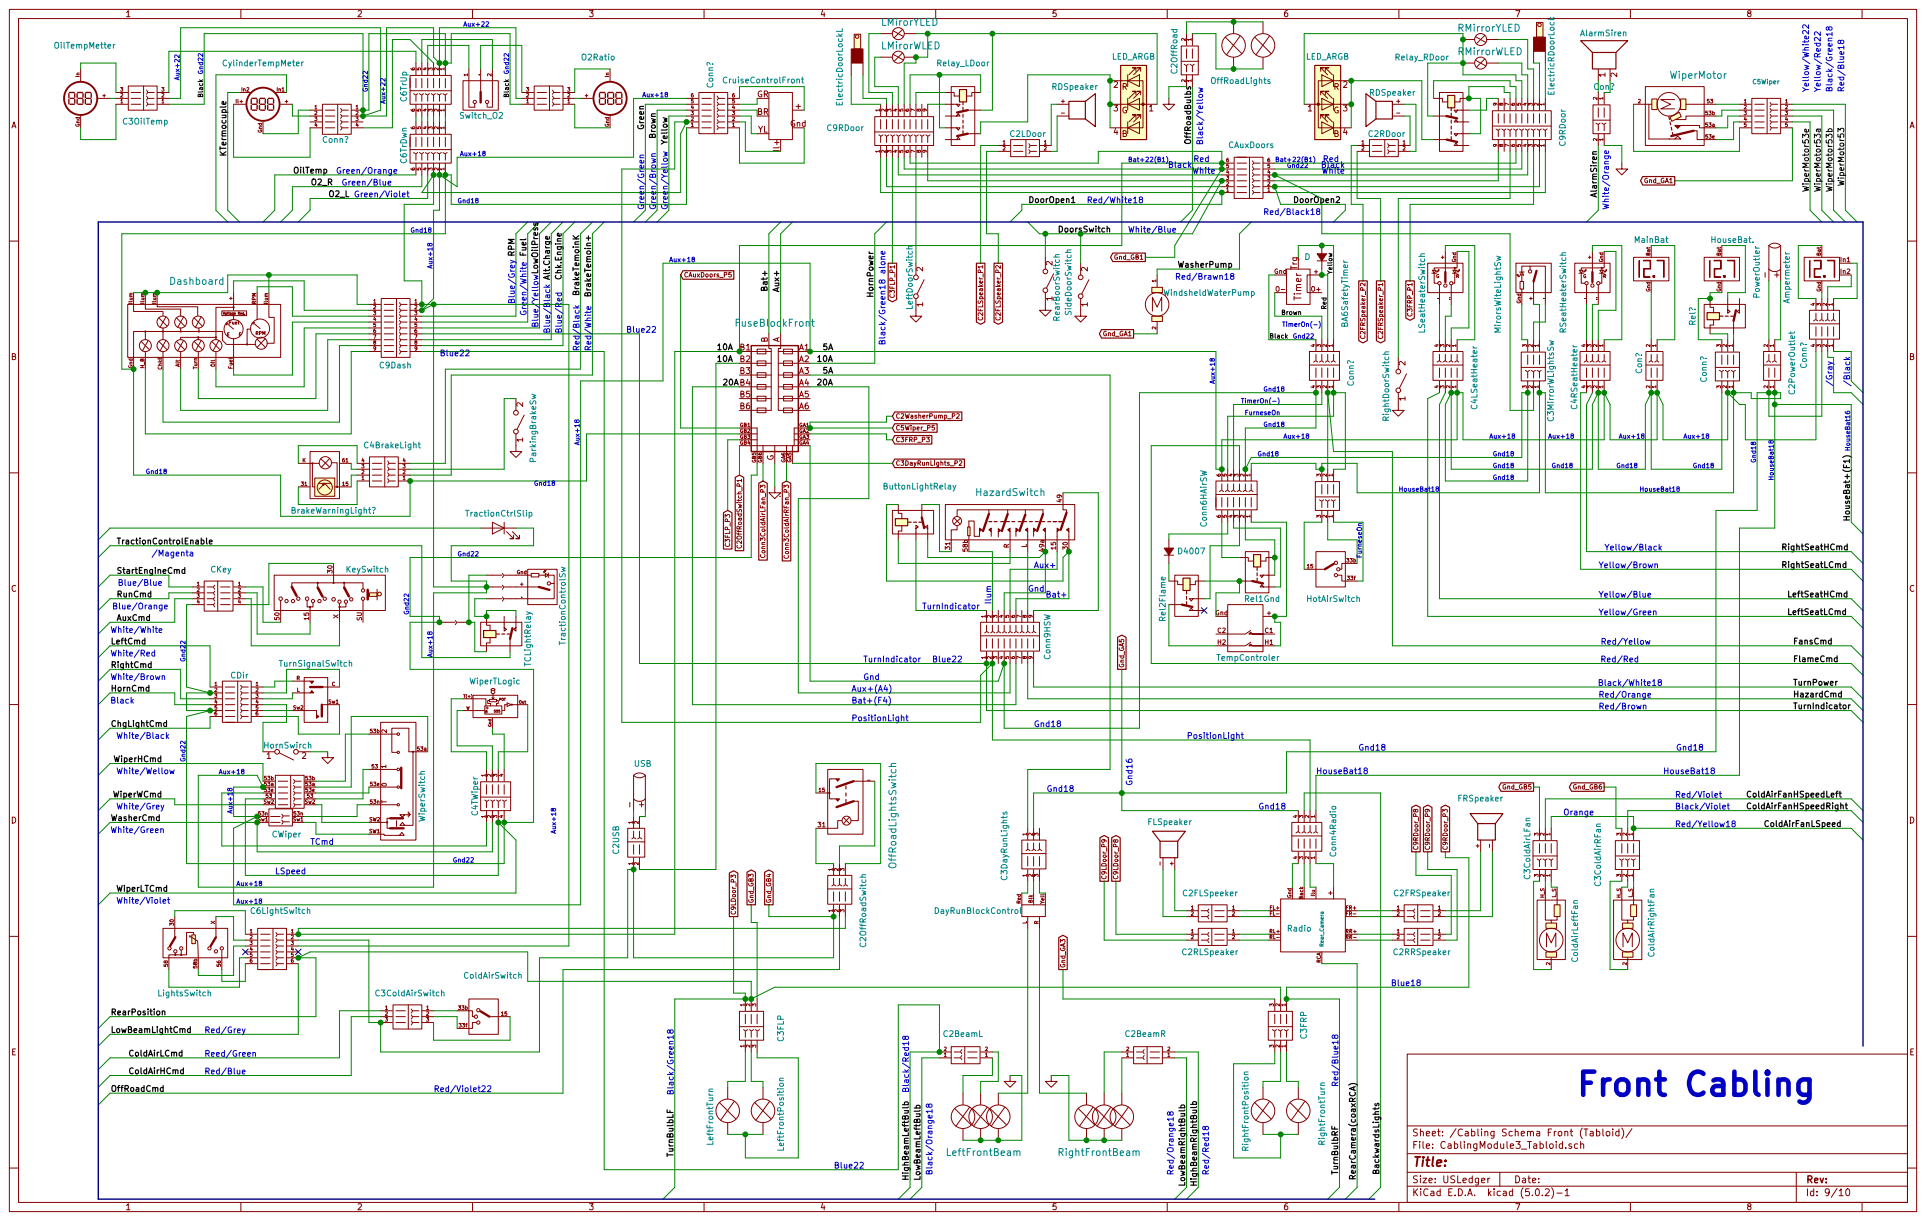
[picture p14: page 9]

1 2 SideDoorSwitch 1 2 LeftDoorSwitch 1 2 RearBoorSwitch ElectricRDoorLock ElectricDoorLockL

2 2 C2OffRoad Relay_RDoor Relay_LDoor Black/Orange18 Red/Orange18 Red/Red18 Black/Red181 1

4 4 Conn? Gnd18 FurneseOn TimerOn(-) Gnd22 FurneseOn RearCamera(coaxRCA) BackwardsLights BrakeTemoin+

-+ FLSpeaker C9LDoor_P9 C9LDoor_P8 Gnd_GA3 C3FRP_P3 Bat+ TurnIndicator TurnIndicator PositionLight

TractionControlEnable
White/White White/Green White/Grey White/Violet White/Wellow
Sw1 Sw2 TurnSignalSwitch LeftCmd RightCmd

+Back FL+ FL- FR+ FR- Gnd Ilu Rear_Camera RCA RL+ RL- RR+ RR- Radio

Sheet: /Cabling Schema Front (Tabloid)/
File: CablingModule3_Tabloid.sch
Id: 9/10 Title:

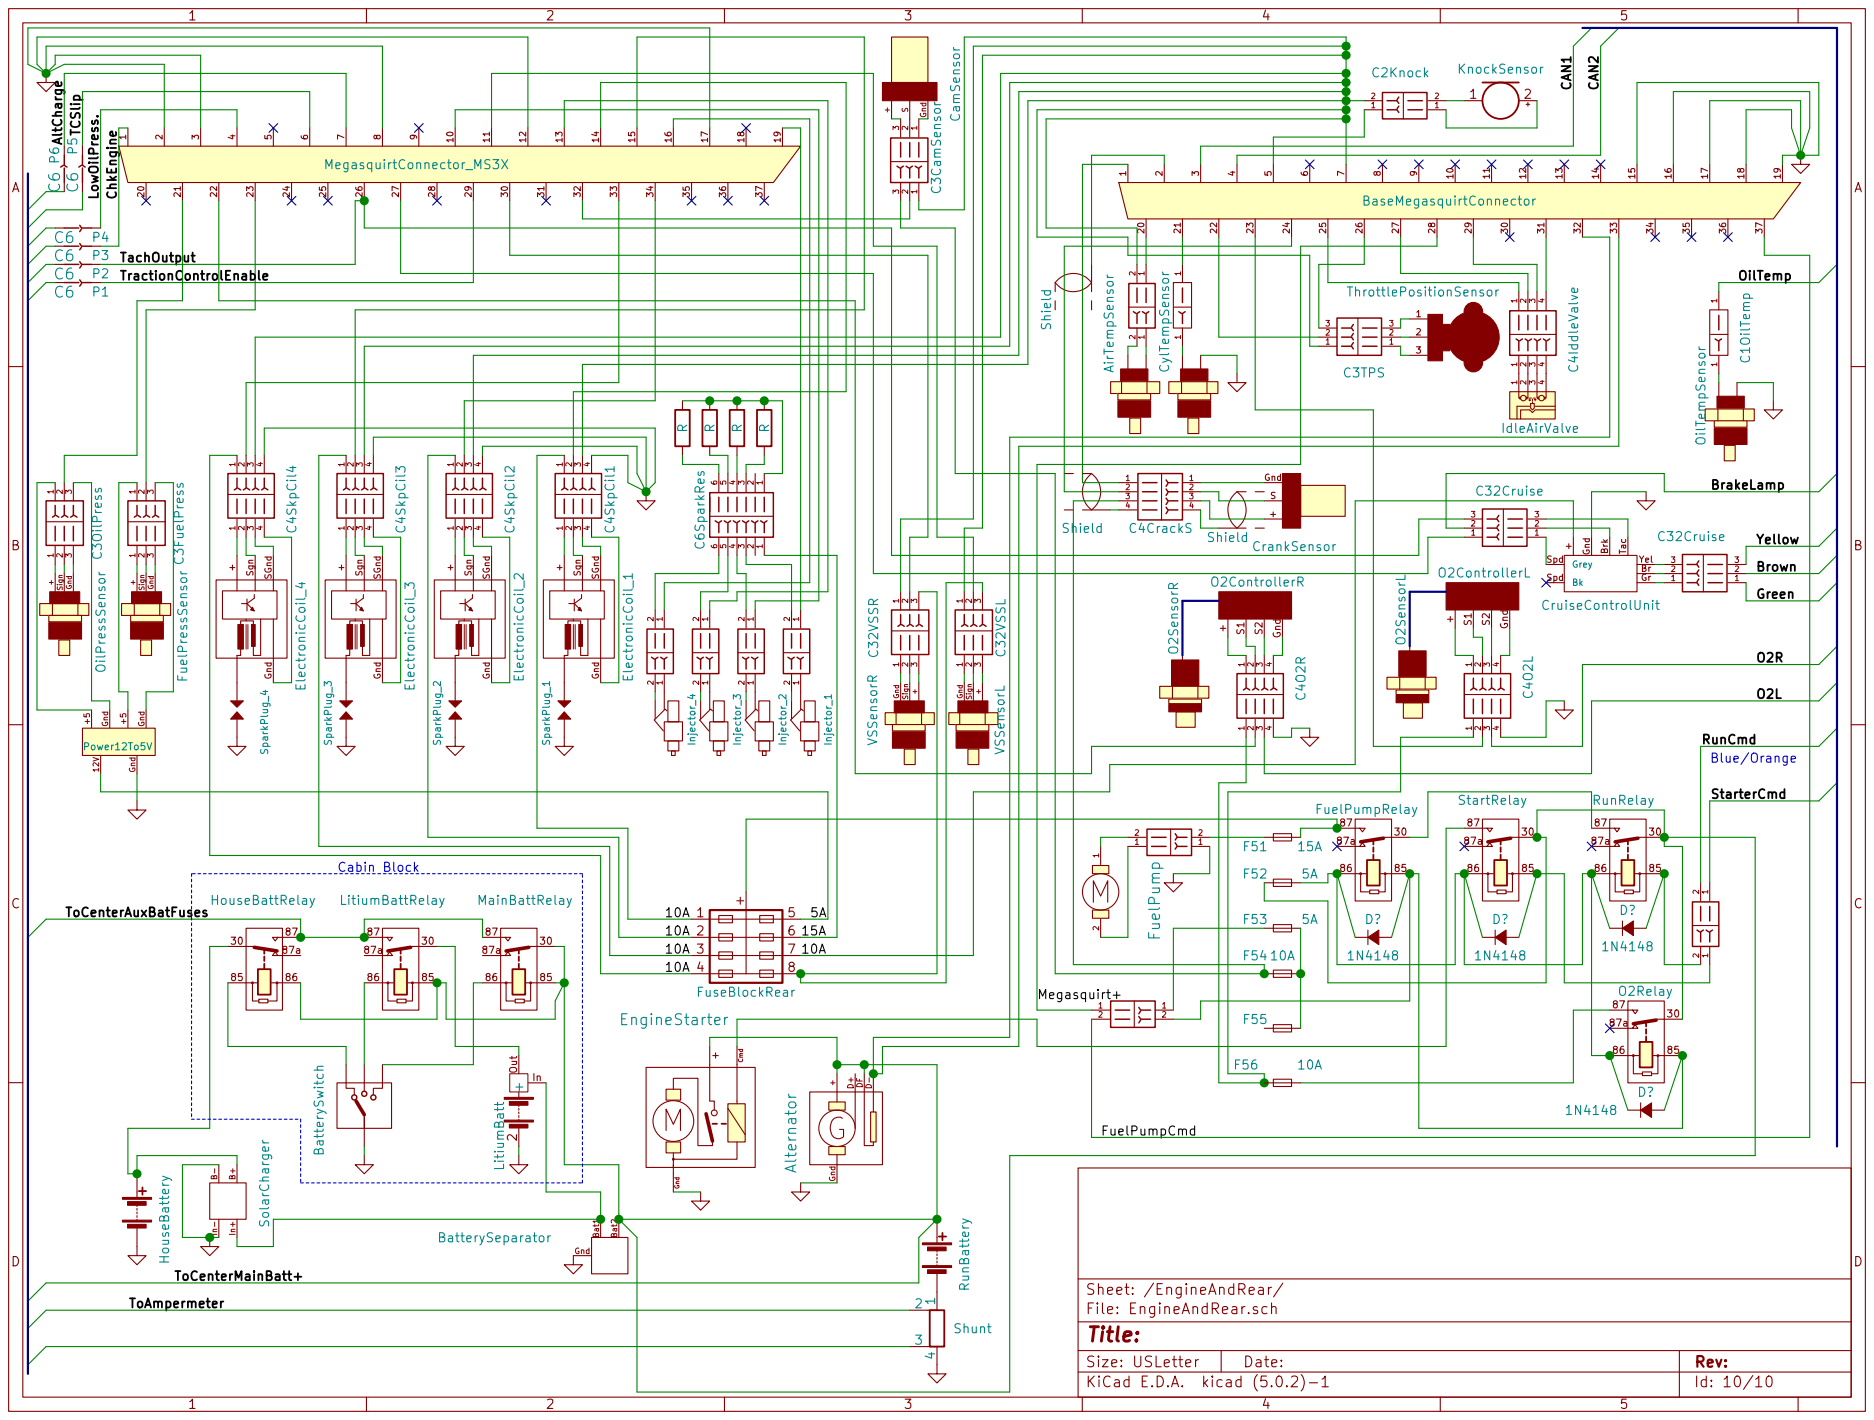
[picture p15: page 10]

+ Sign Gnd OilPressSensor+ Sign Gnd FuelPressSensor +5+5 12V Gnd Gnd Gnd Power12To5V TractionControlEnable TachOutput 1 1

3 ThrottlePositionSensor +GndS CrankSensor Shield +

+ Br Gnd Brk Gr Bk Spd Grey Spd Tac Yel CruiseControlUnit 1 1

+ Gnd SGnd Sgn ElectronicCoil_4 SparkPlug_4 SparkPlug_3 SparkPlug_2 SparkPlug_1 Injector_4 Injector_3 Injector_2 Injector_1 RunBattery

+D+ DFD- GndAlternator HouseBattery B- B+ In- In+SolarChargerBatterySwitch
