antoniancu/vw-t2-ms3-custom-wiring/CablingModule3-Cabling Schema Front.pdf

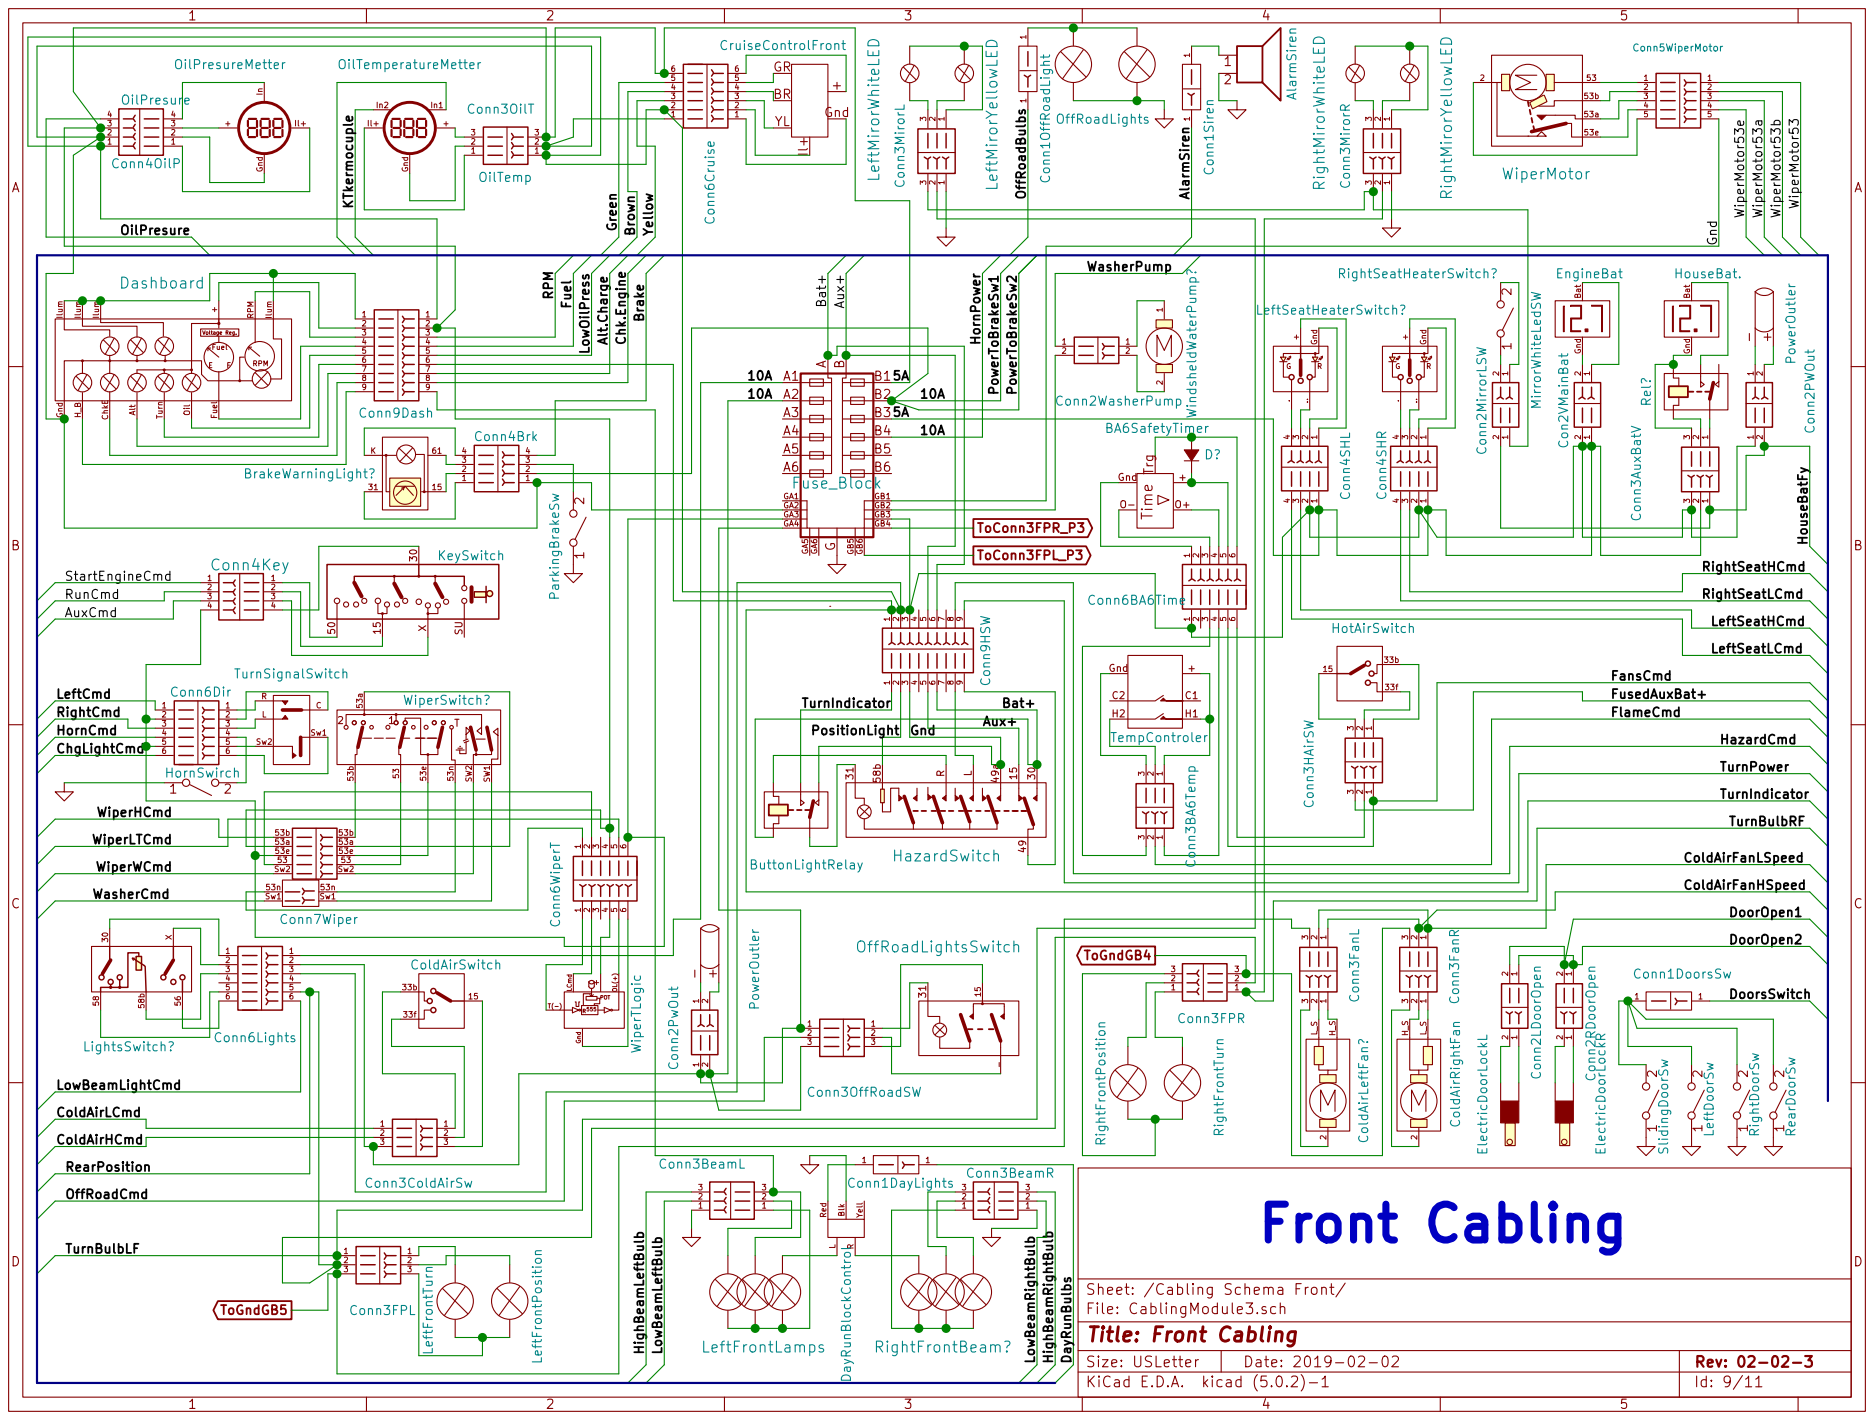
[picture p16: page 1]

5A
10A

Sheet: /Cabling Schema Front/
File: CablingModule3.sch
Id: 9/11 Title: Front Cabling
