antoniancu/vw-t2-ms3-custom-wiring/LogicModule3-Logic_Schema_By_Module_3.pdf

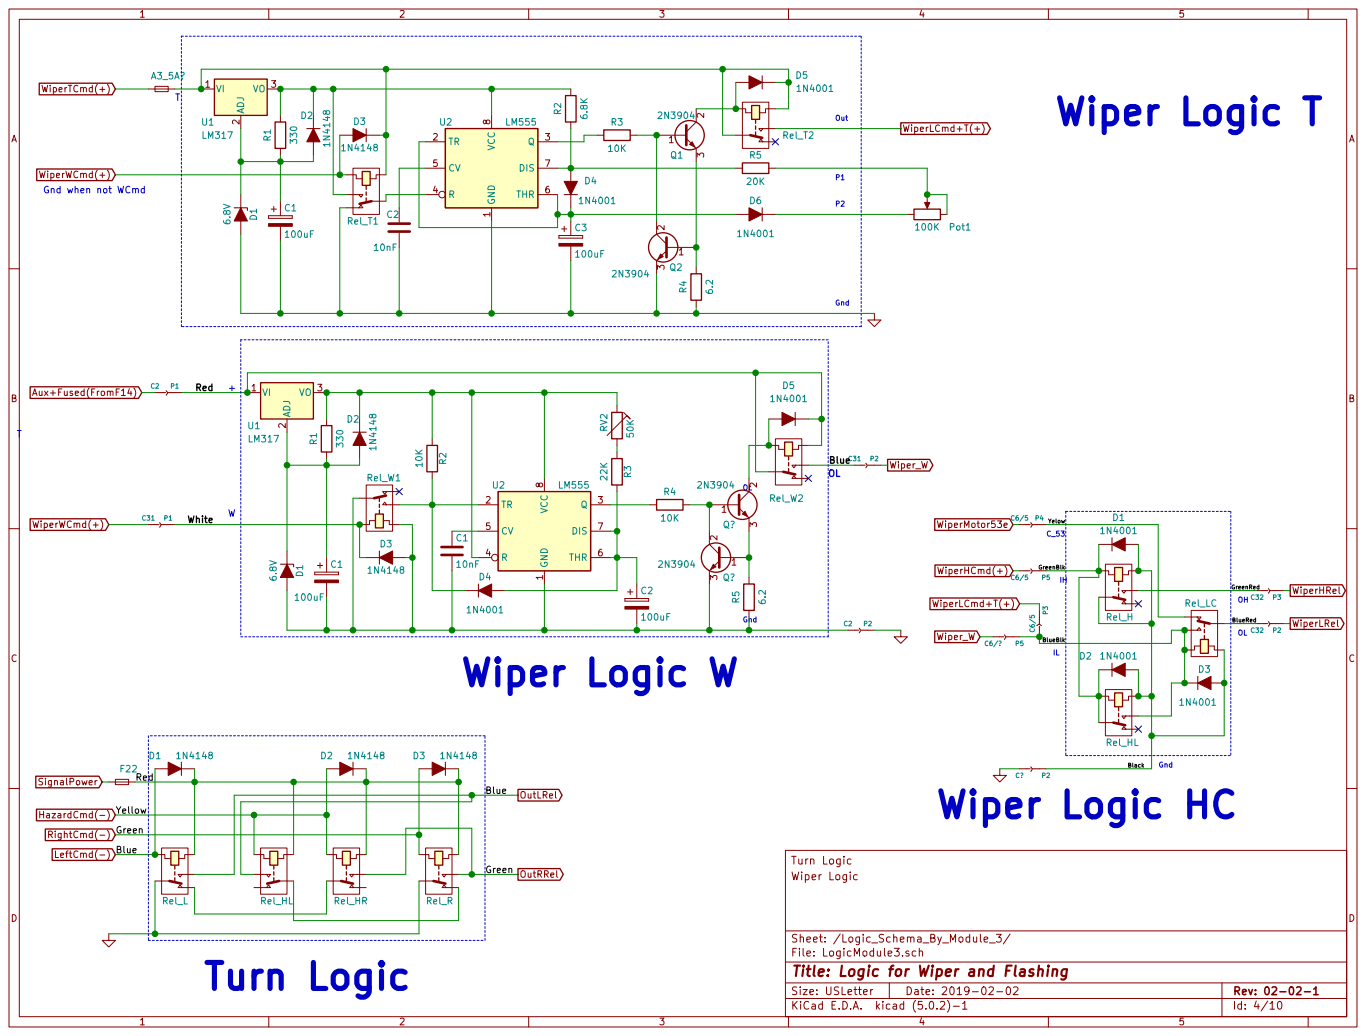
[picture p17: page 1]

Sheet: /Logic_Schema_By_Module_3/
File: LogicModule3.sch
Id: 4/10 Title: Logic for Wiper and Flashing
