antoniancu/vw-t2-ms3-custom-wiring/Cablaj/PCB.kicad_pcb

## KiCad design KiCAD/popcoffee/popcoffee.sch


Parts:
C1: 100nF; C_Rect_L9.0mm_W3.9mm_P7.50mm_MKT; Voltage 630V
D1, D2, D3, D4: 1N4004; D_DO-41_SOD81_P10.16mm_Horizontal
D5: Heater LED; LED_D3.0mm
D6: Fan LED; LED_D3.0mm
D7: BTA24; TO-220-3_Vertical
D8: D_Schottky; D_DO-41_SOD81_P10.16mm_Horizontal
J1: Rede; SolderWirePad_1x02_P7.62mm_Drill2mm
J2: FanDC; TerminalBlock_bornier-2_P5.08mm
J3: Heater; TerminalBlock_bornier-2_P5.08mm
M1: HLK-PM01
M2: ESP32-DEVKIT-V1
Q1: IRF540N; TO-220-3_Vertical
R1, R5: 1k; R_Axial_DIN0207_L6.3mm_D2.5mm_P15.24mm_Horizontal
R2: 10k; R_Axial_DIN0207_L6.3mm_D2.5mm_P15.24mm_Horizontal
R3: 330; R_Axial_DIN0207_L6.3mm_D2.5mm_P15.24mm_Horizontal
R4: 200; R_Axial_DIN0309_L9.0mm_D3.2mm_P15.24mm_Horizontal
R6: 2k7; R_Axial_DIN0309_L9.0mm_D3.2mm_P15.24mm_Horizontal
U1: 4N25; DIP-6_W7.62mm
U2: MOC3020M

Connections:
+5V: M1.3 (Vo+), M2.30 (VIN), R2.2
+24V: J2.1
FanDC: D6.2 (A), R5.2
Fase: C1.2, D1.1 (K), D3.2 (A), D7.1 (A1), J1.1, M1.1 (AC1)
GND: D5.1 (K), D6.1 (K), D8.2 (A), M1.4 (Vo-), M2.2 (GND), M2.29 (GND), Q1.3 (S), U1.4, U2.2
Heater: D5.2 (A), R3.2
unnamed: C1.1, R4.1, R6.2
unnamed: D1.2 (A), D2.2 (A), R1.2
unnamed: D3.1 (K), D4.1 (K), U1.2
unnamed: D7.2 (A2), J3.1, R6.1
unnamed: D7.3 (G), U2.4
unnamed: D8.1 (K), J2.2, Q1.2 (D)
unnamed: Q1.1 (G), R5.1
unnamed: R1.1, U1.1
unnamed: R3.1, U2.1
unnamed: R4.2, U2.6
Neutro: D2.1 (K), D4.2 (A), J1.2, J3.2, M1.2 (AC2)
zerocrossing: R2.1, U1.5

Notes on the sheet:
AC Heater Control
DC Fan control
Zero Crossing Detector
Temperature and Humidity Sensors
